ToleLin/E-bick/docs/02_列印.md

# 02 列印

`STL/` 裡的檔案**已經轉成建議的列印方向**（貼床面在 Z=0），丟進 Bambu Studio 不用再轉。
`PRINT/` 是用 Bambu Studio 2.x CLI 切的參考檔（A1、紋理 PEI 板），克數與時間來自它。
用 Bambu Studio 開啟時會被當成未切片的專案，設定面板也可能顯示預設值；請直接匯入 `STL/`，照下表設定後自己切片。

## 通用設定

| 材料 | 噴嘴 | 層高 | 牆 | 上下層 | 填充 |
|---|---|---|---|---|---|
| PETG-CF | **0.6 硬化鋼**（碳纖會磨壞一般噴嘴） | 0.2 | 6 道 | 5 / 5 | gyroid，見下表 |
| PETG HF | 0.6（同上） | 0.2 | 6 道 | 5 / 5 | 100% |
| TPU 95A HF | 0.4 | 0.2 | 3 道 | 預設 | 20% |

PETG-CF 用「Bambu PETG-CF @BBL A1 0.8 nozzle」耗材預設（0.6 噴嘴也適用），機器設定裡噴嘴類型改成硬化鋼。

## 主機（印一套）

| 檔案 | 材料 | 填充 | 支撐 | 重量 | 時間 | 擺放 |
|---|---|---|---|---|---|---|
| `unit/01_housing_front_PETG-CF.stl` | PETG-CF | 25% | 樹狀（樞軸耳板下方） | 338 g | 12.8 h | 燕尾座正面貼床、立著印；45° 燕尾槽免支撐 |
| `unit/02_housing_rear_PETG-CF.stl` | PETG-CF | 25% | 樹狀（少量） | 326 g | 11.5 h | 前接合面貼床、立著印 |
| `unit/03_bay_lid_PETG-CF.stl` | PETG-CF | 40% | 無 | 45 g | 1.5 h | 蓋面朝下 |
| `unit/04_swing_arm_PETG-CF.stl` | PETG-CF | **60%** | 樹狀（馬達座板下方） | 235 g | 8.7 h | 外側面貼床，已斜 25° 才放得進 256 mm 盤 |
| `unit/05_lift_crank_inner_PETG-HF.stl` | PETG HF | 100% | 無 | 4 g | 0.2 h | 平放 |
| `unit/06_lift_crank_outer_PETG-HF.stl` | PETG HF | 100% | 無 | 7 g | 0.4 h | 曲柄片貼床 |
| `unit/08_lift_handle_PETG-HF.stl` | PETG HF | 100% | 無 | 14 g | 0.5 h | 平放 |
| `unit/09_spacer_pivot_x1_PETG-HF.stl` | PETG HF | 100% | 無 | 2 g | 0.4 h | 立著，印 1 個 |
| `unit/09_spacer_eye_top_x2_PETG-HF.stl` | PETG HF | 100% | 無 | 0.4 g | 0.2 h | **印 2 個** |
| `unit/09_spacer_eye_low_x2_PETG-HF.stl` | PETG HF | 100% | 無 | 0.4 g | 0.2 h | **印 2 個** |
| `unit/07_roller_sleeve_TPU95A.stl` | TPU 95A | 20% | 無 | 50 g | 3.3 h | 立著印 |
| `unit/10_estop_kicker_PETG-HF.stl` | PETG HF（紅） | 100% | 無 | 4.8 g | 0.3 h | 緊急停止觸發桿，內側面貼床 |
| `unit/09_spacer_kicker_x1_PETG-HF.stl` | PETG HF | 100% | 無 | 0.2 g | 0.2 h | 觸發桿軸的墊管 |
| `vendor/makita_cc0/makita18v.3mf`＋`battery_terminal.stl` | PETG-CF | 依原作者 | 依原作者（原作者註明要支撐） | — | — | |

主機合計約 **1.03 kg、40 小時**（不含電池座）。

## 緊急停止拉桿（每台車一支）

| 檔案 | 材料 | 填充 | 支撐 | 重量 | 時間 |
|---|---|---|---|---|---|
| `estop_lever/L/estop_lever_upper_bar22p2_L_PETG-CF.stl`（依車把管徑選 22p2／23p8／25p4） | PETG-CF | 60% | 無（切平面貼床） | 9.6 g | 0.7 h |
| `estop_lever/L/estop_lever_lower_L_PETG-CF.stl` | PETG-CF | 60% | 無 | 8.1 g | 0.5 h |
| `estop_lever/L/estop_lever_blade_L_PETG-HF.stl` | PETG HF（紅） | 100% | 無 | 7.4 g | 0.3 h |

`L` 裝車把左半邊，`R` 資料夾是鏡像版。

**強度相關：**
- 擺臂是受力最大的件（樞軸處彎矩約 50 N·m）。60% 填充、6 道牆，牆的方向與受力平面一致。
- 兩個殼體主要受壓，25% 填充就夠。

## 座管座（每台車印一組）

1. 先用 `tools/fit_my_bike.py` 或 README 的車型表，決定**款式**（std／mtb／fold／minivelo）。
2. 量座管直徑（用游標卡尺，或看座管上的刻字，例如 27.2、31.6）。
3. 到 `STL/base/D<管徑>/` 印這三個檔：
   - `base_front_D<管徑>_PETG-CF.stl`（前半）
   - `base_rear_D<管徑>_<款式>_PETG-CF.stl`（後半，帶燕尾）
   - `liner_D<管徑>_TPU95A.stl`（1 mm 內襯）

例：座管 27.2、標準款 → `STL/base/D27p2/` 的 `base_front_D27p2`、`base_rear_D27p2_std`、`liner_D27p2`。

| 檔案 | 材料 | 填充 | 支撐 | 重量 | 時間 |
|---|---|---|---|---|---|
| base_front | PETG-CF | 60% | 無 | 32 g | 1.5 h |
| base_rear（std） | PETG-CF | 60% | 無（minivelo 款可能要少量支撐） | 64 g | 2.5 h |
| liner | TPU 95A | 20% | 無 | 5 g | 0.7 h |

管徑有 25.4、27.2、28.6、30.9、31.6、33.9、34.9。

**其他管徑**：改 `src/params.py` 的 `POST_DIAMETERS`，再執行 `src/export_print.py`。內襯厚 1 mm、夾具內徑＝管徑＋2.3 mm。

## 印完要做的事

- 608 軸承座孔徑設成 22.1 mm。太緊用砂紙修，太鬆用一層膠帶或樂泰 641。
- M3 熱壓銅螺母：用烙鐵壓進電控艙四角與中間的 5 根柱子。
- 燕尾：主機要能順順滑進座管座。卡住的話，用砂紙磨母槽的斜面（每邊預留 0.3 mm）。
