ToleLin/E-bick/docs/04_設計說明.md

# 04 設計說明：為什麼長這樣

這份記錄每個主要決定的理由與計算，方便之後改版或有人分支改作。分析程式在 `analysis/`、`src/check_*.py`、`src/forces.py`。

## 1. 需求

1. 一台主機在不同腳踏車之間快速換裝，不用工具。
2. 照一般自行車規格，能涵蓋大多數車型。
3. 以 3D 列印為主（PETG-CF、PETG HF、TPU 95A HF；Bambu A1，0.6 硬化鋼噴嘴）。
4. 馬達與電子零件在蝦皮、露天、淘寶買得到。
5. 開源。

## 2. 為什麼是「座管座留在車上＋主機燕尾快拆」

- 夾具是摩擦驅動最常出事的地方。Kepler eBoost 用墊片湊管徑，騎幾分鐘就鬆脫撞輪；BoosterPack 夾不乾淨會整組旋轉。
- 每台車留一個依管徑**精準列印**的座管座（加 1 mm TPU 內襯、4×M5），只裝一次，裝好就不再動。
- 主機在每台車上的位置由座管座決定，換車時不用重調。這也是 Rubbee X 與 Piotr F-drive 的做法。
- 燕尾**由下往上**滑入、頂到上止擋：輪胎往上的反力把主機推進止擋，所以快拆銷平常只承受主機自重與顛簸。

## 3. 為什麼不做「越出力壓越緊」的自增壓

擺臂式摩擦驅動有一條判斷規則：從擺臂樞軸往後輪軸畫一條線，滾輪接觸點在這條線**前方**，驅動反力才會把滾輪往輪胎壓（自增壓）。

用 8 種車型的實際幾何掃過一遍（`analysis/contact_mechanics.py`）：
- 樞軸在座管附近時，這條線落在胎頂前方 24–34°。
- 那個位置正好是**後上叉和框煞橋**的位置，74 mm 寬的馬達塞不進去。
- 把樞軸移到別處讓所有車型都自增壓，最佳化結果是樞軸要在立管上緣下方約 12 cm 的後上叉之間，不可行（`fit_with_reach.py` 等）。

所以改走「**接近中性**」：
- 滾輪接觸在胎頂附近，驅動力對正向力的影響 k = dN/dF 只有 −0.5～+0.17。
- 壓胎力全部由**定力氣壓棒**提供。Rubbee X 也是用 200 N 氣壓彈簧。

## 4. 主機剛性固定＋短擺臂，而不是「整台主機當擺臂」

「整台主機繞座管轉」（參考商品的樣子）在幾何上需要約 300 mm 臂長，彈簧離樞軸又近，要上千牛頓的彈簧才夠，不實際。

改成主機剛性固定在座管座上，內部一支 230 mm 擺臂，氣壓棒裝在離樞軸 180 mm 處，槓桿比好。

## 5. 一台主機怎麼適用 20 吋到 29 吋：座管座帶傾角

- 不同車的胎頂位置差很多：
  - 公路車胎頂在座管束下方約 14 cm。
  - 斜上管登山車的胎頂幾乎和座管束同高。
  - 小徑車的五通比後軸高。
- 公路車的主機不能再往下（會撞立管上緣），登山車不能再往上（會撞座墊）。只靠調夾具高度，擺臂角會差到 22°，超出氣壓棒行程。

解法：把「每台車不同」的調整放在**座管座**上。
- 燕尾可以有傾角（std 0°、mtb −10°、fold +10°、minivelo +30° 並後伸 40 mm），再搭配夾具高度 s。
- 最佳化（`analysis/fit_final.py`）的限制條件：
  - 接觸角在胎頂前 −12°～+14°。
  - |k| ≤ 0.5。
  - 樞軸離胎面 ≥ 25 mm，擺臂離胎面 ≥ 15 mm。
  - 樞軸與馬達要在後上叉線的後上方。
- 結果：
  - 樞軸在座管後 110 mm、夾具中心下 80 mm，臂長 230 mm，**8 種車型擺臂工作角都落在 −20° ± 2.5°**。
  - 主機長度約 36 cm，由「胎頂離座管 24–32 cm」決定，無法再短。

## 6. 氣壓棒與過死點抬臂機構

- **氣壓棒規格**：100 mm、行程 30、250 N。因為各車擺臂角一致，工作長度落在 80–96 mm（壓縮 4–20 mm），各車壓力只差 ±5%。
- **抬臂機構**：氣壓棒上端接在偏心半徑 17 mm 的曲柄上。
  - **工作位置**：曲柄過死點 6°，氣壓棒把把手壓在擋塊上，自己鎖住。
  - **扳到另一個死點**：氣壓棒伸到全長，變成拉桿把擺臂拉起，滾輪離胎 18–38 mm。
- **為什麼是兩片獨立曲柄**：在抬起的死點，氣壓棒軸線會穿過曲柄軸心，所以軸心不能有貫穿的軸。
  - 兩片曲柄各用短軸裝在塔的內外牆上，中間只靠曲柄銷相連，Ø15 的氣壓棒本體能從中間穿過。
- **扳桿手力**：從抬起扳回工作位置，最大約 41 N（`src/forces.py`）。

## 7. 受力（`src/forces.py`，250 N 氣壓棒）

| 項目 | 數值 |
|---|---|
| 正向力 N | 216–237 N（8 車型） |
| 乾地可傳推力（μ 0.6） | 110–152 N |
| 濕地可傳推力（μ 0.3） | 62–72 N |
| 需求：25 km/h 巡航 250 W | 36 N |
| 需求：6% 坡 12 km/h | 58 N |

μ 是設計假設：滾輪對輪胎沒有可靠的量測資料，研究報告用乾 0.6、濕 0.3。

**建議第一個實驗**：印幾個 TPU 滾輪套，用彈簧秤實測乾、濕兩種狀態的 μ。

## 8. 馬達、滾輪、電壓

詳見 [01 零件與採購](01_零件與採購.md) 第 1 節與 [研究報告](research/motor.md)。

- 外殼當滾輪（A 架構）：零件最少，軸承負載落在馬達兩顆內部軸承之間，壽命夠（估計 L10 約 3,700 h）。
- 研究也比較了「小滾輪＋10S 36V＋外側軸承」（B 架構），它銅損較低。但 Ø35 小滾輪的壓胎損失與磨胎較大，而且需要 36V 電池，失去牧田電池隨插即用的方便。
- **v0.1 選 A 架構＋牧田 18V。**

## 9. 列印方向決定的幾何細節

- 燕尾從 60° 改成 **45°**：主機前段立著印時，燕尾槽斜面是 45° 懸空，免支撐。
- 主機後段接合面貼床立著印，車尾不加擋板（45° 斜裙會撞到抬起的馬達）。
- 擺臂外側面拉平到同一平面，平放貼床；斜放 25° 才放得進 A1 的 256 mm 盤。
- STL 用 build123d 直接網格化（公差 0.02 mm）。cadgen 內建網格精度是零件尺寸的 0.25%，會讓 608 軸承孔誤差 0.4 mm。

## 10. 控制

- 只做踏頻助力，不做油門（法規、安全）。
- 標準藍牙 CSC 踏頻感測器綁在曲柄，ESP32-C3 收踏頻，用 UART 送 `setCurrent` 給 VESC。
- 車速用滾輪轉速算：摩擦驅動時滾輪表面速度＝胎面速度＝車速，和輪徑無關。
- 停踩判定：最後一圈曲柄事件後 1.2 秒。感測器約每秒通知一次，總延遲約 1–2.5 秒，符合檢測基準「3 秒內停止」。
- 已知限制：
  - 踏頻感測器分不出倒踩（檢測基準要求倒踩不出力）。
  - 沒有煞車斷電開關（要接線，違反免接線的設計）。
- 為什麼不用 VESC 內建 PAS：它只吃雙霍爾有線 PAS，而且預設佔用 UART 腳位。

## 10.5 緊急停止拉桿（v0.2）

詳見 [05 緊急停止拉桿](05_緊急停止拉桿.md)。設計重點：

- **純機械，直接把滾輪抬離輪胎**。不管電子有沒有故障，推進都會中斷；依需求這版不做電子斷電。
- **借用現成的過死點抬臂機構**：工作位置只過死點 6°，鎖緊力矩 0.53–0.58 N·m，所以只要把它往回推過死點，氣壓棒自己會完成抬起，而且停住後不會自己回去（自鎖）。
- **觸發桿要把把手頂到過死點 16°**：曲柄軸是塑膠孔配螺絲，摩擦估計 0.5 N·m，剛過死點時氣壓棒的推力矩只有 0.02 N·m 推不動。
  - 過死點 16° 時推力矩約 1.2 N·m，是摩擦的兩倍以上。
  - 觸發桿幾何用 `analysis/estop_kicker.py` 搜尋：轉 32.4°、拉線 12.7 mm、張力約 47 N。
- **觸發桿只推不拉**：把手被頂開後可以自由轉到抬起位置；恢復時把手往下壓，會順便把觸發桿與拉線推回原位。
- **車把拉桿的配置**：和一般煞車把相同（拉桿片朝外、線頭在樞軸前方、線管往內出去），但：
  - 夾在龍頭附近的空車把上，拉桿片只有 52 mm，避開現有變速把、煞車把。
  - v0.3 精簡：樞軸移到車把正前方、線頭臂 20 mm，座子 45 × 64 × 47 mm（v0.2 是 56 × 74 × 50），三件 25 g；列印件之間會動的地方每邊留 1 mm（使用者的列印誤差約 0.2 cm）。
  - 拉桿平面在車把下方，拉的時候從車把下面掃過。
  - 座子拆成上下兩件，都能免支撐列印。
- **每台車一支拉桿與線**，主機端的線管座是「內線從側槽放進去、線管頭從前方推入」（不靠卡扣），線頭從側面放進觸發桿，換車時 5 秒接上。

## 11. 已知限制與下一版

**未實測**：

| 項目 | 驗證方式 |
|---|---|
| 滾輪 μ | 實測 |
| TPU 滾輪套耐磨性 | 騎乘測試 |
| 氣壓棒實際尺寸／力量 | 到貨確認 |
| 列印件長期潛變 | PETG-CF 在夏天曝曬的溫度下 |
| 牧田電池座端子能承受的電流 | 實測 |

**下一版可以做**：
- 曲柄上加陀螺儀，在 0.3 秒內偵測停踩與倒踩（研究報告第二階段）。
- 把手加藍牙段位按鈕。
- 減重：殼體鏤空、樞軸耳板改桁架。目前主機列印件約 1.0 kg。
- 碳纖座管專用的寬夾具。
- 36V（兩顆牧田串聯）版本。

## 12. 參考與致謝

- MikeKaiser/eBike_v1（MIT）：參數化座管夾、擺臂 45° 規則
- JK_Prints Universal Friction Drive（CC BY-SA）：PETG 0.6 噴嘴厚牆參數
- Piotr Strzałka F-drive：每台車留底座的換裝架構
- Kepler 摩擦驅動（Endless-Sphere）：密封軸承樞軸、限位、VESC FOC 經驗
- Rubbee X：200 N 氣壓彈簧
- fablab.ee、axel：CC0 牧田電池座與端子
- 完整調查報告與查證：`docs/research/`
