ToleLin/E-bick/docs/01_零件與採購.md

# 01 零件與採購

價格是 2026-11-07 查到的參考值。
- 露天的標價是用露天 API 實際抓到的。
- 蝦皮、淘寶的商品頁搜尋引擎抓不到，只列搜尋關鍵字；標「估」的是沒有查證的估計值。

露天幾個主力賣場是代購、**成交數 0**，下單前請看賣家評價或問清楚出貨地。

## 1. 馬達：6374 外轉子無刷馬達（170KV、有感）

### 為什麼選它

PostRoller 用馬達外殼直接當滾輪（外面套 3 mm TPU，Ø69 mm）。

**扭力與銅損：**
- 6374 的馬達常數最大（Km ≈ 0.23 N·m/√W），同樣推力下銅損最小。6354 約多一倍，5065 約多兩倍半。
- 6% 爬坡（推力 58 N，滾輪扭力 2.0 N·m）時，6374 銅損約 77 W，6354 會到 150 W。

**選 170KV 而不是 140KV，原因有二：**
- 牧田 18V 電池快沒電（15 V）時，170KV 的 80% 空載轉速仍有 26 km/h，140KV 只剩 22 km/h。
- 下坡時滾輪被輪胎帶著轉，反電動勢會超過電池電壓並回灌電池。170KV 要到約 48 km/h 才發生，140KV 約 40 km/h 就會。

### 規格

依 Flipsky 官方圖面，副廠 6374 尺寸可能不同，**到貨請實量**。

| 項目 | 數值 |
|---|---|
| 外形 | 外殼 Ø63 × 74 mm，含軸總長 108 mm |
| 安裝孔 | **4×M4、深 5 mm、孔位圓 PCD Ø44**（擺臂的馬達座開長孔，PCD 30–46 都能鎖） |
| 軸 | Ø8 mm 圓軸附鍵槽（鍵寬 3、長 20），從**安裝面那側**伸出 34 mm（根部 Ø10 台階） |
| 出線 | 三相線＋6 pin 霍爾線，從安裝面附近的凸座徑向出線（凸座朝擺臂方向裝） |
| 極數 | 14 極（7 對極） |
| 電壓／電流 | 3–12S；最大 85 A、3500 W、8 N·m（本設計只用到約 28–35 A） |
| 扭力常數 | 170KV：Kt ≈ 0.056 N·m/A；140KV：Kt 0.067 N·m/A、相電阻 0.044 Ω |
| 重量 | 約 0.98 kg |

在本設計裡的工作點（Ø69 滾輪）：

| 情況 | 推力 | 滾輪扭力 | 相電流（170KV） | 電池電流（18 V） |
|---|---|---|---|---|
| 平路 25 km/h，約 250 W | 36 N | 1.24 N·m | 約 22 A | 約 15 A |
| 6% 坡 12 km/h | 58 N | 2.0 N·m | 約 36 A | 約 13 A |

### 哪裡買

| 管道 | 商品／關鍵字 | 價格 |
|---|---|---|
| 露天 | 「【台灣現貨】板車外轉子無刷大電機馬達 N5065 6354 N6364 C6374…」規格選 **6374-170KV 有感** https://www.ruten.com.tw/item/show?22543223395022 | NT$2,228 |
| 露天 | 「【可開統編】6374 170KV無刷馬達滑板車馬達…」有感 https://www.ruten.com.tw/item/show?22632318875322 | NT$2,220 |
| Flipsky 官網 | 6374 140/170/190KV（Battle Hardened） | US$87（約 NT$2,860，未含運費關稅） |
| 蝦皮／露天關鍵字 | `6374 170KV 有感`、`6374 無刷 外轉子 有感` | |
| 淘寶關鍵字 | `6374 外转子无刷电机 有感 170KV`、`翻天 Flipsky 6374` | 約 ¥140–210（估） |

**要買「有感」（帶霍爾線）的版本。**
- 摩擦驅動在車子動起來後馬達本來就在轉，無感也能用。
- 但有感版低速、坡道起步比較穩，也比較安靜。

## 2. 電控：VESC（Makerbase MKSESC MINI V6.7）

| 項目 | 數值 |
|---|---|
| 電壓 | 8–60 V（3–12S），牧田 5S 在範圍內 |
| 電流 | 連續 50 A、峰值 150 A |
| 尺寸 | 67 × 39 × 20 mm（電控艙內用束帶固定） |
| 介面 | USB、CAN、UART（接 ESP32）、霍爾 |
| 價格 | 露天 NT$2,309 https://www.ruten.com.tw/item/show?22641852738525 （成交 0）；NT$2,430 https://www.ruten.com.tw/item/show?22521646076876 |
| 關鍵字 | `Makerbase VESC MINI V6.7`、`班傑明電調 VESC 6.7`、淘寶 `Makerbase VESC MINI 6.7 本杰明电调` |

可替代：Flipsky Mini FSESC 6.7 PRO 70A（4–12S，尺寸相同，官網 US$57）。

**不建議用便宜的航模電變或電動車控制器：**
- 摩擦驅動起步負載大，航模電變搭大馬達會失步尖叫。
- 36V 電動車控制器跑不了這種高轉速外轉子馬達（沒有查證）。

## 3. 電池：牧田 18V（5S）

| 項目 | 說明 |
|---|---|
| 電池 | 牧田 BL1850B（5Ah、約 90 Wh、約 630 g）或 BL1860B（6Ah）。原廠約 NT$3,500–4,300；副廠便宜但保護電路品質不一 |
| 續航 | 摩擦驅動實測約 5–8 Wh/km（輔助騎乘）→ 5Ah 約 10–15 km、6Ah 約 11–18 km |
| 電池座 | 印 `vendor/makita_cc0/makita18v.3mf`（fablab.ee，CC0），端子用 `battery_terminal.stl`（axel，CC0）＋6.3 mm 公插片；鎖在主機右側牆的 4 個 M5 孔 |
| 現成座（替代） | 蝦皮「大藝牧田電池轉XT60/DC輸出底座」NT$238–258（外形不同，要自己改孔位） |
| 注意 | 牧田電池的過放／過熱保護可能要靠工具端讀信號腳才會作動。只接正負極時，**一定要在 VESC 設低電壓斷電**（見 03） |

## 4. 控制：藍牙踏頻感測器＋ESP32-C3

| 零件 | 說明 | 價格 |
|---|---|---|
| 踏頻感測器 | Magene 邁金 S3+（藍牙＋ANT+，CR2032）。用橡皮圈綁曲柄；裝電池的方式決定「速度／踏頻」模式，要設成**踏頻**。其他標準藍牙 CSC 踏頻器也可以 | 蝦皮 NT$450–550 |
| ESP32-C3 SuperMini | 跑 `firmware/`，用 UART 命令 VESC | 蝦皮 NT$38–100（關鍵字 `ESP32-C3 SuperMini`） |
| 12 mm 按鍵（常開、瞬時） | 段位切換，裝電控艙右側 | 約 NT$30（估） |
| 5 mm LED＋330 Ω | 段位指示 | 約 NT$5 |
| 16 mm 自鎖開關 | 切 ESP32 的 5 V＝助力總開關 | 約 NT$40（估） |

## 5. 機構件

| 零件 | 規格 | 數量 | 關鍵字／備註 |
|---|---|---|---|
| 氣壓棒 | **眼到眼 100 mm、行程 30 mm、250 N**，兩端 Ø8 眼（或 M8 牙＋眼端頭）。乾燥地區、高壓公路胎可用 200 N，常下雨用 300 N | 1 | 蝦皮 `氣壓棒 100mm 行程30 250N`、淘寶 `气弹簧 100mm 行程30 250N`（**規格與價格未查證**，約 NT$150–300） |
| 608 軸承 | 8×22×7，建議 608-2RS（雙面膠封，防水） | 3 | 樞軸 2、馬達軸端 1 |
| 球鎖快拆銷 | Ø6 × 有效長 60 mm，附拉環／繩 | 1 | `球頭快拆銷 6mm 60`、淘寶 `球头快拆销 6*60`（未查證） |
| M8 螺絲 | 樞軸 M8×70＋防鬆螺帽＋墊圈 2；氣壓棒下眼 M8×45＋防鬆螺帽；上眼 M8×35＋防鬆螺帽；內曲柄短軸 M8×16；把手 M8×16；M8 螺帽 2 顆（埋進內、外曲柄） | 各 1 | |
| M5 螺絲 | 座管座 M5×20＋螺帽 ×4（每台車）；主機前後段 M5×16＋螺帽 ×4；電池座 M5×12＋螺帽 ×4 | | |
| M4 螺絲 | M4×10（馬達固定，**馬達螺孔只有 5 mm 深，不要用更長的**） | 4 | |
| M3 | M3 熱壓銅螺母 ×5＋M3×8 ×5（電控艙蓋） | | |
| 魔鬼氈束帶 | 25 mm 寬，從座管座前方扣環綁到座墊弓，防止整組繞座管轉 | 每台車 1 | |

## 6. 電線與接頭

| 零件 | 說明 |
|---|---|
| XT60 公母各 1 | 電池座 → VESC（XT30 只能持續 15 A，不夠） |
| 12 AWG 矽膠線 | 約 0.5 m 紅黑 |
| 30 A 汽車插片保險絲＋防水座 | 電池正極出口 |
| 馬達延長線 | 6374 的三相線與霍爾線長度要到電控艙（擺臂內側走線，約 25 cm），不夠就用 3.5/4 mm 香蕉頭延長＋霍爾延長線 |

## 6.5 緊急停止拉桿（v0.2，機械式）

詳見 [05 緊急停止拉桿](05_緊急停止拉桿.md)。每台車要一支車把拉桿與一條煞車線；主機端只多一個觸發桿。

| 零件 | 數量 | 關鍵字／備註 |
|---|---|---|
| MTB 煞車內線（Ø1.5，圓柱線頭） | 每台車 1 | 蝦皮 `剎車線 內線 登山車`，約 NT$30–60 |
| 5 mm 煞車線管＋線管頭 | 每台車約 1.5 m＋2 個 | `剎車線管 5mm`，約 NT$50–100 |
| 免焊螺絲線頭 | 每台車 1 | `剎車線頭 免焊` / 淘寶 `刹车线头 螺丝固定`（未查證），約 NT$20 |
| M4×20＋防鬆螺帽 2 組、M4×16＋螺帽 1 組 | 每支拉桿 | 拉桿樞軸、上下件接合、夾具鎖緊 |
| M4 熱壓銅螺母＋M4×14＋墊圈 | 主機 1 組 | 觸發桿的軸 |

## 7. 材料

| 線材 | 用量 | 用在 |
|---|---|---|
| PETG-CF（Bambu PETG-CF） | 約 1.0 kg | 主機殼、擺臂、艙蓋、座管座（需**硬化鋼噴嘴**） |
| PETG HF | 約 30 g | 抬臂桿、曲柄、墊片 |
| TPU 95A HF | 約 55 g＋每台車 5 g | 滾輪套、座管內襯 |

## 8. 成本估計（不含電池、充電器、工具）

| 項目 | 約 NT$ |
|---|---|
| 6374 170KV 有感 | 2,200 |
| VESC MINI V6.7 | 2,300–2,450 |
| 踏頻感測器＋ESP32＋按鍵開關 | 650 |
| 氣壓棒、軸承、快拆銷、螺絲 | 600（估） |
| 電線、接頭、保險絲、電池座端子 | 350（估） |
| 緊急停止拉桿（每台車：煞車線、線管、螺絲） | 150（估） |
| 線材 | 1,200（估） |
| **合計** | **約 7,450–7,950** |

對照：你截圖的 eBay 18V 摩擦驅動套件 US$339（約 NT$11,137）；市售呂布雲輪摩擦輪＋控制器 NT$7,365，整套含電池 NT$17,606 起。
