ToleLin/E-bick/docs/research/regulation.md

# 研究報告：regulation

# 台灣法規與安全限制：DIY 外掛式摩擦驅動電動助力（查證日 2026-11-07）

**一句話結論：** 依現行條文，DIY 自製、沒有通過型式審驗的外掛助力單元，**不能合法騎上公眾通行的道路**。可能被套用的條文有好幾條，最重的是把整台車「依汽車之拼裝車輛處理」，罰鍰新臺幣 3,600～36,000 元，車子會被當場移置保管，條文也有沒入規定。

**法規層級說明：**
- 法律是「道路交通管理處罰條例」（以下稱處罰條例）。
- 命令是「道路交通安全規則」（以下稱道安規則）、「電動輔助自行車及微型電動二輪車型式安全審驗管理辦法」（以下稱審驗辦法），以及「電動輔助自行車安全檢測基準」（以下稱檢測基準）。
- 下面寫的都是條文內容加出處，不是法律意見。

---

## 1. 定義：電動輔助自行車與微型電動二輪車

| 項目 | 電動輔助自行車（電輔車） | 微型電動二輪車（微電車，2022 年前叫「電動自行車」） | 出處 |
|---|---|---|---|
| 法律定義 | 經型式審驗合格、**以人力為主、電力為輔**、最大行駛速率 25 km/h 以下、車重 40 kg 以下的二輪車 | 經型式審驗合格、**以電力為主**、25 km/h 以下、不含電池 40 kg 以下或含電池 60 kg 以下 | [處罰條例§69](https://law.moj.gov.tw/LawClass/LawSingle.aspx?pcode=K0040012&flno=69) |
| 上路前提 | 檢測及型式審驗合格，並「黏貼審驗合格標章」（貼在下管明顯處） | 檢測及型式審驗合格，並登記、領用、懸掛牌照 | [§69-1](https://law.moj.gov.tw/LawClass/LawSingle.aspx?pcode=K0040012&flno=69-1)、[審驗辦法§3、§11](https://law.moj.gov.tw/LawClass/LawAll.aspx?pcode=K0040068) |
| 誰能申請審驗 | 國內完成車由合格製造廠申請，進口完成車由代理商或進口人申請。**辦法沒有讓個人替自己改裝的車申請的管道**，也沒有改裝套件的審驗類別 | 同左 | [審驗辦法§5、§9](https://law.moj.gov.tw/LawClass/LawAll.aspx?pcode=K0040068) |
| 強制險 | 條文沒有要求 | 必須投保強制汽車責任保險，沒保就不受理登記或發照 | [§69-1](https://law.moj.gov.tw/LawClass/LawSingle.aspx?pcode=K0040012&flno=69-1) |
| 安全帽 | 處罰條例沒有罰則（§73 的安全帽罰則只寫微電車） | 必須戴，未戴罰 NT$300（§73，修正條文 2026-10-31 施行） | [§73](https://law.moj.gov.tw/LawClass/LawSingle.aspx?pcode=K0040012&flno=73) |
| 年齡 | §72-2 沒有列電輔車 | 未滿 14 歲騎乘罰 600～1,200 元，車輛移置保管 | [§72-2](https://law.moj.gov.tw/LawClass/LawAll.aspx?pcode=K0040012) |
| 掛牌時程 | 不掛牌 | 2022-05-04 公布修正、2022-11-30 施行；舊車兩年緩衝，113-11-30（2024-11-30）前要完成掛牌 | [車安中心專文](http://vsccdms.vscc.org.tw/webfile/Epaper/500000285/File/9ad97bb2-0636-4017-9dc8-5ef300c696cc.pdf)、[交通部168](https://168.motc.gov.tw/theme/ebike)、[中央社 2024-11-30](https://www.cna.com.tw/news/asoc/202411300065.aspx) |

**電輔車的技術門檻**（[檢測基準修正規定，行政院公報 2022-11-29](https://gazette.nat.gov.tw/EG_FileManager/eguploadpub/eg028227/ch06/type2/gov50/num23/images/Eg01.pdf)，2024-01-01 起各型式都適用）：
- **重量：** 車輛空重含電池 ≤ 40 kg，不得裝側方腳踏板。
- **電壓：** 鋰電池最高工作電壓 < 60 V。18 V 是 5 串，滿電 21.0 V，在限制內。
- **馬達功率：** 最大輸出 < 400 W，或最大連續額定 ≤ 250 W。
- **停踩斷電：** 停止踩踏 3 秒內停止出力；或有煞車斷電開關者 5 公尺內、沒有者 2 公尺內停止輔助。倒踩時馬達不得驅動。
- **超速斷電：** 超過 25 km/h 時，要在 25 km/h +10% 範圍內自動斷電，且要有防止擅改速限的設計。
- **故障斷電：** 煞車訊號線或超速訊號線短路、斷路時，3 秒內斷電。
- **防竄改：** 不得以外部行為、改軟體或韌體變更速限，電子控制裝置要有防擅改封印。
- **油門：** 唯一允許不踩就出力的是「起動輔助模式」，最高 6 km/h，而且必須靠騎乘者持續操作才會作動。所以**純油門、不踩也能走的設計，在法律上會被歸到「以電力為主」的微電車**，要審驗、掛牌、保險。
- **微電車的技術門檻：** 搜尋摘要看到臺北市法規文件寫「電動機最大輸出功率小於 1 kW、鋰電池最高工作電壓小於 60 V」（[來源](https://www.laws.taipei.gov.tw/lawatt/Law/A040110051045100-20221128-1000-005.pdf)）。**這點是 UNVERIFIED，原文沒有逐字核對。**

---

## 2. 自製、未審驗的外掛單元能不能上公眾道路？

**相關條文：**
- [道安規則§119](https://law.moj.gov.tw/LawClass/LawSingle.aspx?pcode=K0040013&flno=119) 第 4 項原文：「慢車擅自加裝補助引擎或馬達行駛者，依汽車之拼裝車輛處理。」同條第 1 項規定慢車不得擅自變更裝置。
- [審驗辦法](https://law.moj.gov.tw/LawClass/LawAll.aspx?pcode=K0040068)沒有個人或改裝套件的審驗途徑，所以「每台腳踏車快速換裝」的單元在制度上**無法取得**審驗合格標章或牌照。

**可能適用的罰則**（實際用哪一條由警察或監理機關認定，我無法替你判斷）：

| 情境 | 條文 | 處罰 |
|---|---|---|
| 一般腳踏車加裝馬達，被依道安規則 §119 第 4 項當成拼裝車 | [處罰條例§12 第1項第2款](https://law.moj.gov.tw/LawClass/LawSingle.aspx?pcode=K0040012&flno=12) | 罰所有人 3,600～36,000 元，當場移置保管；第 2 項明文第 2 款的車輛「並沒入之」。新罰額 2025-09-30 施行（[工商時報](https://www.ctee.com.tw/news/20250930700616-431401)、[NOWnews](https://www.nownews.com/news/6706656)） |
| 被認定為未經型式審驗的電輔車 | [§71 第2項](https://law.moj.gov.tw/LawClass/LawSingle.aspx?pcode=K0040012&flno=71) | 「未經型式審驗合格之電動輔助自行車，於道路行駛者，沒入之。」 |
| 有油門、以電力為主，被認定為未審驗、未掛牌的微電車 | [§71-1](https://law.moj.gov.tw/LawClass/LawSingle.aspx?pcode=K0040012&flno=71-1) | 罰 1,200～3,600 元並禁止行駛；未經型式審驗合格的「沒入之」 |
| 改變電輔車或微電車的電子控制裝置或原有規格 | [§72 第2項](https://law.moj.gov.tw/LawClass/LawSingle.aspx?pcode=K0040012&flno=72) | 3,600～7,200 元，禁止行駛，責令改正 |
| 一般慢車擅自變更裝置 | §72 第1項 | 300～1,200 元，限期改正 |
| 交通部舊函釋：電輔車超過 25 km/h | [交通部 110-08-24 函](https://www.mvdis.gov.tw/webMvdisLaw/SorderContent.aspx?SOID=16138)，指向 [§32-1](https://law.moj.gov.tw/LawClass/LawSingle.aspx?pcode=K0040012&flno=32-1) | 1,200～3,600 元並禁止行駛。這是 2022 年修法前的函釋，部分可能已被新條文取代 |

**執法實例：** 2022 年台南警方沒入 63 輛拼裝微電車、40 個改裝電控（[中央社](https://www.cna.com.tw/news/aloc/202208120053.aspx)）。我沒有找到專門取締「腳踏車外掛摩擦驅動」的新聞或函釋，這部分是 UNVERIFIED。

**私人土地與測試：**
- [§3](https://law.moj.gov.tw/LawClass/LawSingle.aspx?pcode=K0040012&flno=3) 規定「道路」是「公路、街道、巷衖、廣場、騎樓、走廊或其他供公眾通行之地方」。照字面，不供公眾通行的私人封閉場地不在範圍內。
- 但騎樓、廣場、開放通行的私人巷道、河濱自行車道都可能算道路。
- 我沒有找到個人上路測試的豁免條文。審驗辦法 §9 第 3 項的「自行使用、每年不超過三輛」只適用於進口完成車。

**事故責任：**
- 未審驗的車沒有強制險。
- [民法§191-2](https://law.moj.gov.tw/LawClass/LawSingle.aspx?pcode=B0000001&flno=191-2) 規定「非依軌道行駛之動力車輛」的駕駛人要負推定過失的賠償責任。加了馬達的車是否落入這條，要看個案認定（UNVERIFIED）。

---

## 3. 鋰電池：BSMI 規定與 DIY 安全

**BSMI 規定**（[標檢局「應施檢驗3C二次鋰行動電源等五項商品」規定](https://law.moea.gov.tw/Download.ashx?FileID=190822&id=GL000592&type=LAW)）：
- **電輔車電池：** 「電動輔助自行車用二次鋰電池/組」是應施檢驗商品。檢驗標準 CNS 15387（104年版）、CNS 15424-1、CNS 15424-2（104年版）。檢驗方式為型式認可逐批檢驗或驗證登錄（模式2加3），2019-01-01 起實施邊境管制（輸入規定代號 C02）。「電動自行車用」也列在同一份規定裡。
- **充電器：** 標檢局文件也有列電動輔助自行車用非車載型充電器（[花蓮分局 PDF](https://hualien.bsmi.gov.tw/wSite/public/Data/f1536119976910.pdf)）。這份是掃描檔，我沒能讀到細節，UNVERIFIED。
- **審驗時的用途：** 檢測基準 4.2 允許用標檢局的二次鋰電池組驗證登錄證書代替電池文件（[公報](https://gazette.nat.gov.tw/EG_FileManager/eguploadpub/eg028227/ch06/type2/gov50/num23/images/Eg01.pdf)）。
- **商品檢驗法的範圍**（[全文](https://law.moj.gov.tw/LawClass/LawAll.aspx?pcode=J0100001)）：
  - §6：不合格的應施檢驗商品「不得運出廠場或輸出入」，銷售者也不得陳列或銷售。
  - §9：非銷售的自用品、研發測試用物品進口可以免驗。
  - §60：違規運出廠場、輸入或上市，罰 20 萬～200 萬元。
  - **意思是：** 自己做、自己用，不屬於「上市商品」。但只要開源專案**販售電池或套件**，就要先取得驗證。
- **自用品進口：** 自用品單一項次 ≤ 美金 1,000 元可以直接通關（[標檢局 FAQ](https://www.bsmi.gov.tw/wSite/public/Attachment/f1697612609312.pdf)）。這是搜尋摘要所見，UNVERIFIED。
- **不適用的新規定：** 2027-07-01 起施行的「道路車輛動力用二次鋰電池組」規定只管四輪以上車輛（[台南分局](https://tainan.bsmi.gov.tw/wSite/public/Data/f1766539217438.pdf)，搜尋摘要所見）。
- **集運：** 淘寶集運能不能寄裸電芯（例如 18650）**UNVERIFIED**，要直接問集運業者。

**DIY 電池安全實務：**
- **優先買現成的：** 盡量買有 BSMI 標示的成品電池組。美國 CPSC 建議不要用「非合格人員改造的電池組」或「再利用、二手電芯」（[CPSC 2025-09-04](https://www.cpsc.gov/node/65775)）。
- **BMS：** 一定要有，含過充、過放、過流、短路保護，最好加溫度感測。BMS 規格要配合 5 串 Li-ion（4.2 V/串），電流額定要大於控制器峰值。社群指南認為即使只有一、兩顆電芯也要有 BMS（[Hackaday](https://hackaday.com/2019/06/12/an-exhaustive-guide-to-building-18650-packs)）。
- **保險絲：** 電池正極出口一定要裝主保險絲。額定值低於線材容許電流（工程慣例）。
- **組裝：** 用點焊純鎳片，不要直接焊錫在電芯上；並聯多顆時考慮單顆保險絲線。這些是社群和廠商的建議（[Hackaday](https://hackaday.com/2019/06/12/an-exhaustive-guide-to-building-18650-packs)），可信度屬中等。
- **電芯：** 使用全新、同型號、同批次的電芯。
- **充電器：** 只用原廠或匹配的 CC/CV 21.0 V 專用充電器，CPSC 警告不要用萬用充電器（[CPSC 2024](https://www.cpsc.gov/zh-CN/Newsroom/News-Releases/2024/CPSC-Urges-Consumers-to-Not-Buy-or-Use-Universal-Chargers-with-Micromobility-Products-Due-to-Fire-Hazard)）。
- **充電習慣：** 充電時人要在場、不要睡覺時充（CPSC）。不要在日曬、雨淋或潮濕處充電，不要過充，電池膨脹或異常發熱就立刻停用（新北消防，[公視](https://news.pts.org.tw/article/618242)，搜尋摘要所見）。0°C 以下不得充電，充電溫度範圍 0～45°C（[Battery University BU-410](https://batteryuniversity.com/article/bu-410-charging-at-high-and-low-temperatures)）。
- **列印外殼：** 不要把 PETG-CF 外殼當成電氣絕緣（碳纖維填充材的導電性依配方不同，UNVERIFIED），電芯要另外用青殼紙或熱縮膜絕緣。電池艙要獨立、固定好、避免振動磨損。這兩點是工程建議，不是法規。

---

## 4. 你該知道的事

1. 台灣只有兩種合法的電動自行車：**電輔車**（貼審驗標章）和**微電車**（掛牌加強制險），都必須是業者送審的「完成車」。條文裡沒有讓個人替外掛套件申請審驗的途徑。
2. 道安規則 §119 明文：腳踏車擅自加裝馬達行駛，依汽車的拼裝車輛處理。罰 3,600～36,000 元、當場移置保管，條文還有沒入。另外 §71、§71-1 也有未審驗車輛沒入的規定。
3. 設計上做到 25 km/h 斷電、踩踏感測、≤250 W 連續功率、不加油門，**仍然不會變成合法車**，因為還是沒有審驗合格標章。不過這樣做最接近電輔車的技術規格，也比較安全，值得當作開源設計的預設值。
4. 有油門、不踩也能走的設計，法律上屬於「以電力為主」的微電車，要件更多：審驗、掛牌、保險、戴安全帽、年滿 14 歲。
5. 條文上的「道路」包含騎樓、廣場、巷弄、自行車道等任何供公眾通行的地方。私人封閉場地不算，但我沒有找到測試豁免。
6. 未審驗的車沒有強制險，發生事故要自己承擔民事賠償，可能適用民法 §191-2 的動力車輛推定過失。
7. 自己組 18 V（5 串）電池：電壓遠低於 60 V 的上限，但 BMS、主保險絲、專用充電器、有人在場充電都不能省。CPSC 不建議使用二手或拆機電芯。
8. 開源專案只放設計檔，跟「販售」不同。只要開始賣電池或套件，電池（可能還有充電器）就要先取得 BSMI 驗證，否則依商品檢驗法 §60 可罰 20 萬～200 萬元。
9. 這份整理不能取代主管機關的意見。如果要確定外掛套件在你這個情況會被怎麼處理，可以向交通部公路局或當地警察局、車安中心（VSCC）書面詢問。
