ToleLin/E-bick/docs/img/base_std.png

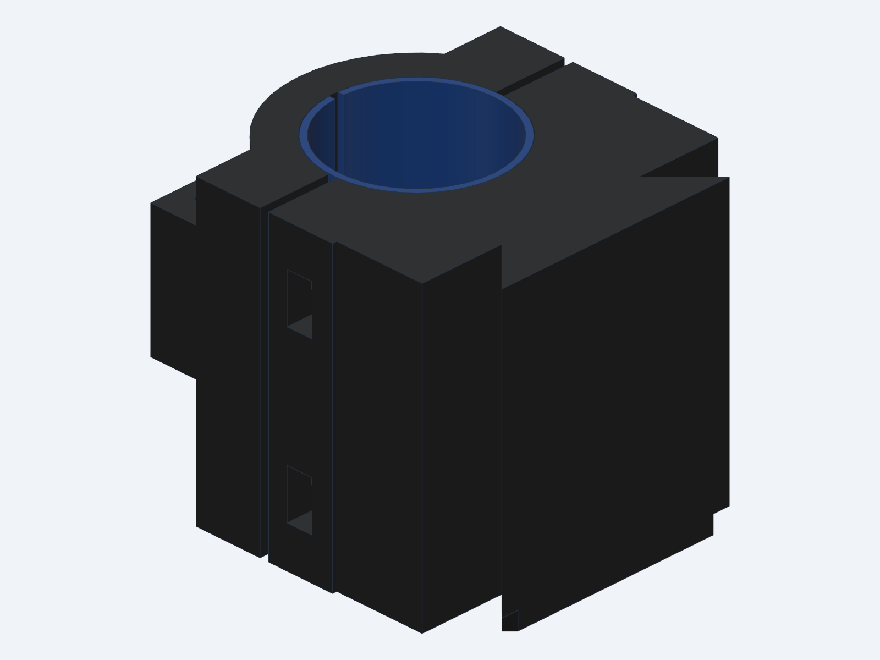
docs/img/base_std.png
