ToleLin/E-bick/docs/img/on_minivelo_left.png

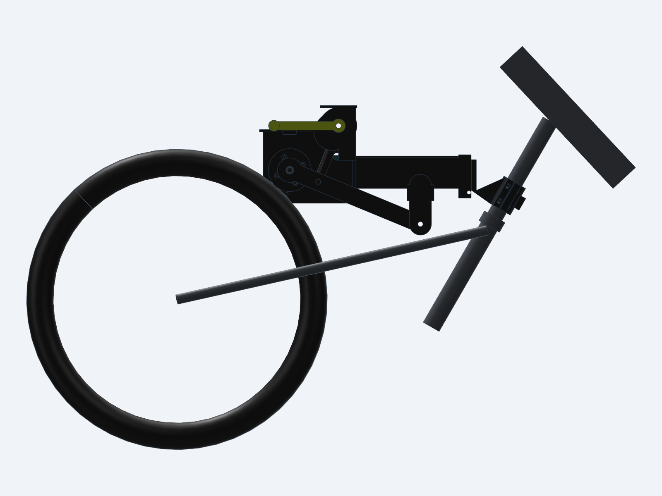
docs/img/on_minivelo_left.png
