ToleLin/E-bick/docs/img/on_mtb29_left.png

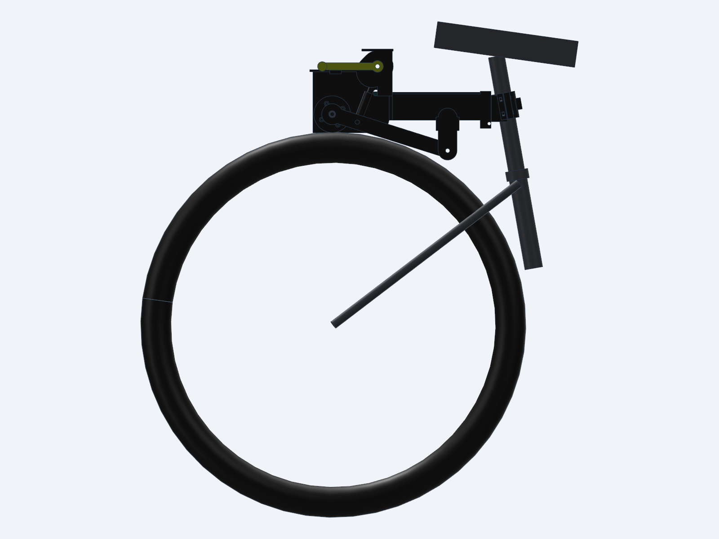
docs/img/on_mtb29_left.png
