ToleLin/E-bick/docs/img/on_road_left.png

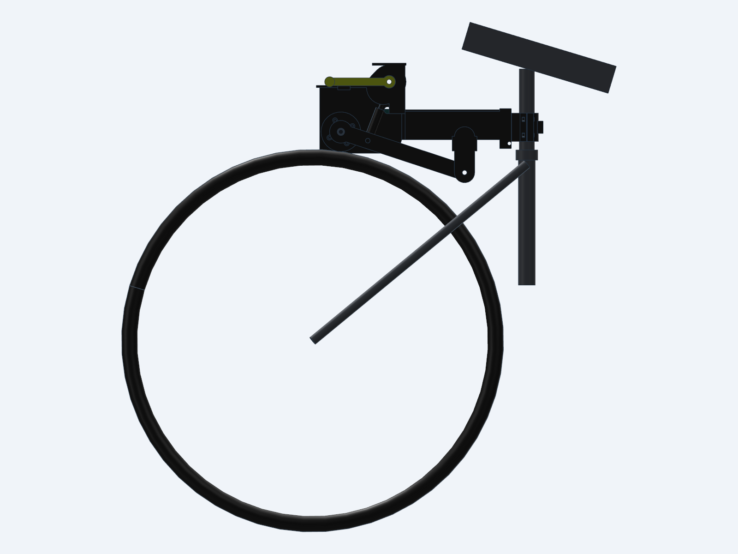
docs/img/on_road_left.png
