ToleLin/E-bick/docs/img/unit_iso.png

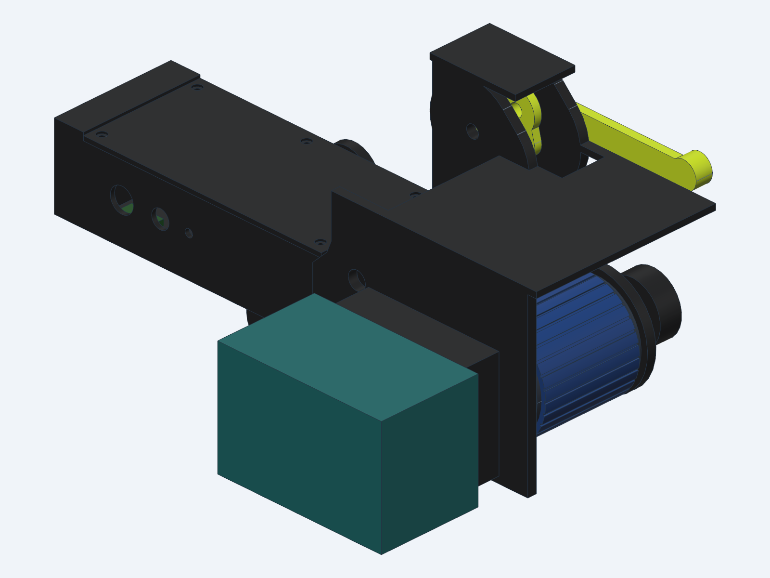
docs/img/unit_iso.png
