ToleLin/E-bick/docs/img/unit_left_lifted.png

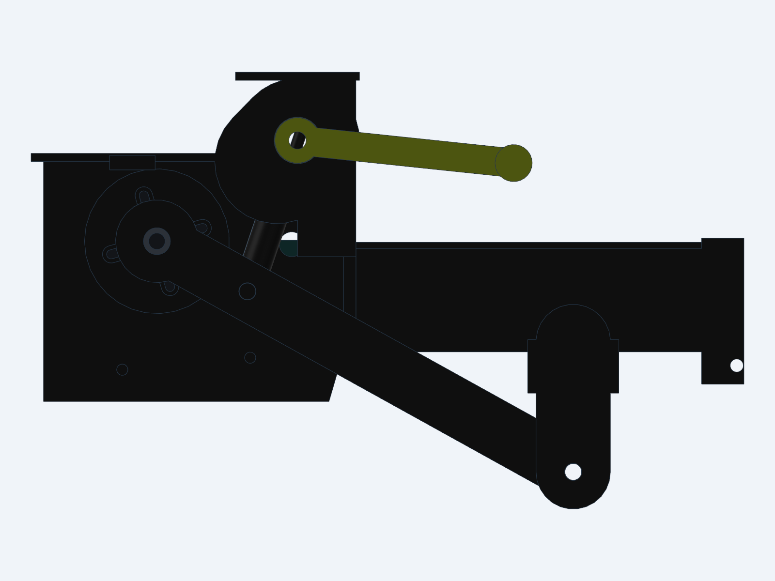
docs/img/unit_left_lifted.png
