ToleLin/E-bick/STEP/postroller_unit.step

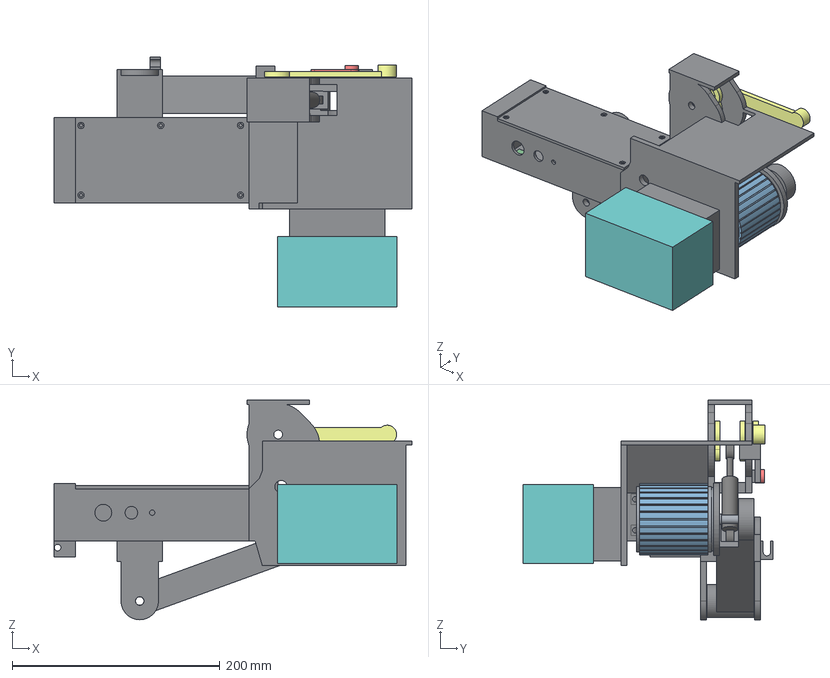
[picture p13: CAD file, 2026-11-08]
STEP/postroller_unit.step
344.5 x 240.8 x 211.2 mm
housing_front
housing_rear
bay_lid
swing_arm
lift_crank_inner
lift_crank_outer
lift_handle
roller_sleeve
motor_6374
gas_spring
bearing_608 x 3
vesc_mks_mini67
esp32_c3_supermini
makita_dock_cc0
makita_battery_18v
estop_kicker
