ToleLin/E-bick/STL/base/D25p4/liner_D25p4_TPU95A.stl

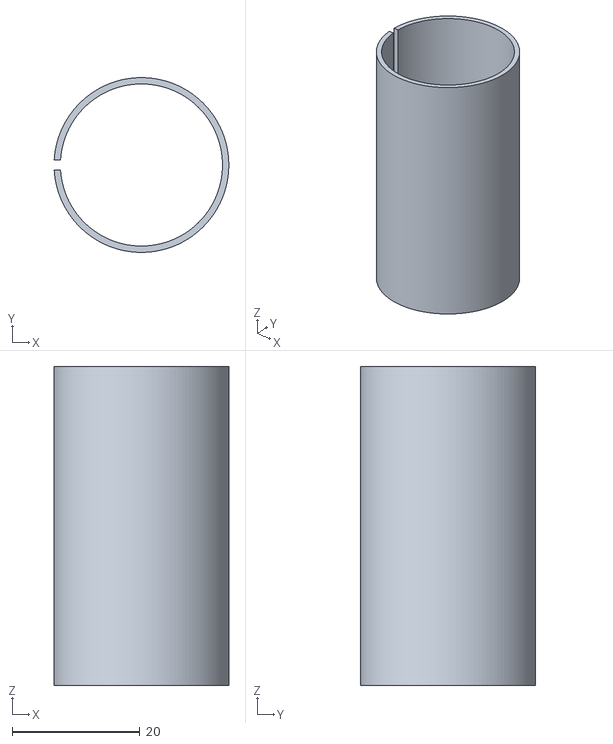
[picture p14: CAD file, 2026-11-08]
STL/base/D25p4/liner_D25p4_TPU95A.stl
27.4 x 27.4 x 50.0
