ToleLin/E-bick/STL/base/D27p2/liner_D27p2_TPU95A.stl

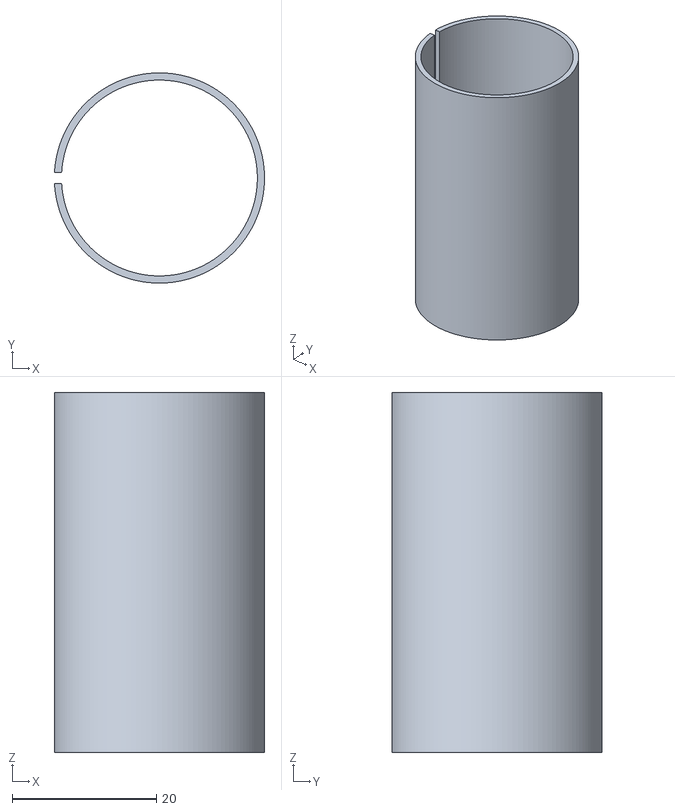
[picture p15: CAD file, 2026-11-08]
STL/base/D27p2/liner_D27p2_TPU95A.stl
29.2 x 29.2 x 50.0
