ToleLin/E-bick/STL/base/D28p6/base_front_D28p6_PETG-CF.stl

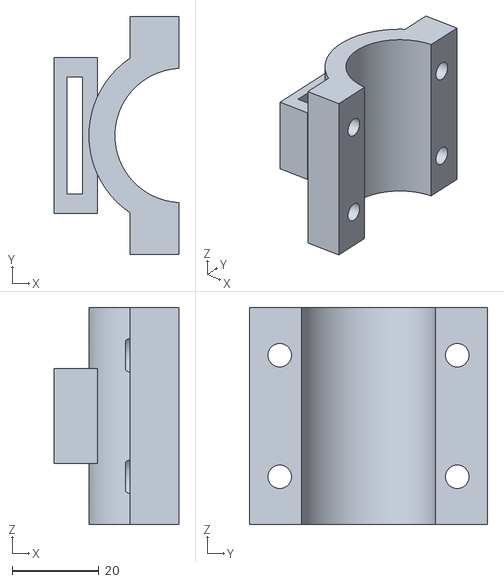
[picture p16: CAD file, 2026-11-08]
STL/base/D28p6/base_front_D28p6_PETG-CF.stl
28.7 x 54.9 x 50.0
