ToleLin/E-bick/STL/base/D30p9/liner_D30p9_TPU95A.stl

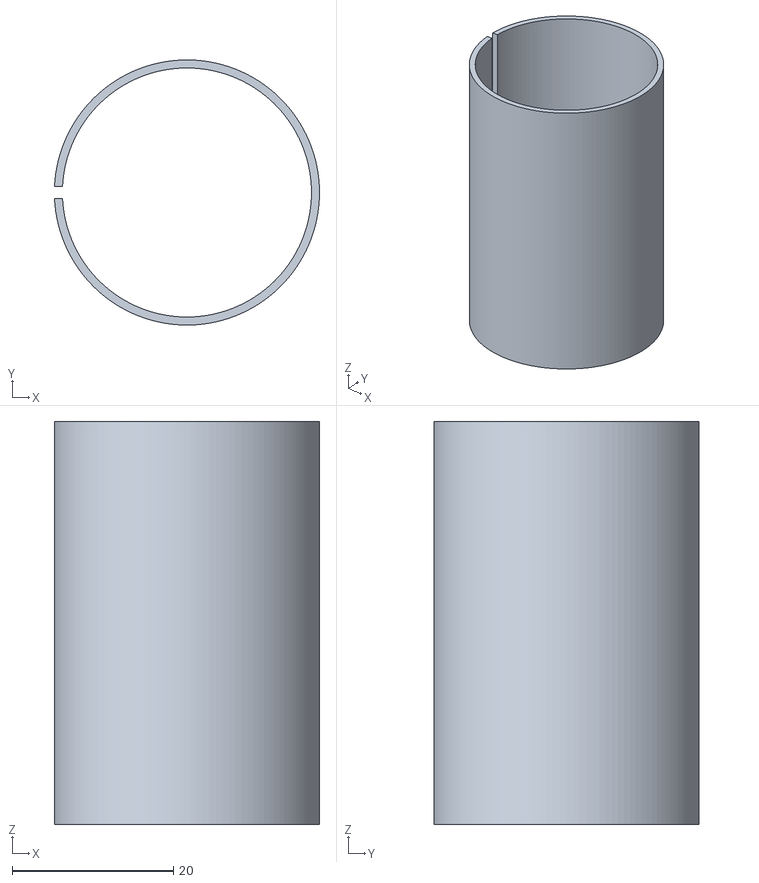
[picture p17: CAD file, 2026-11-08]
STL/base/D30p9/liner_D30p9_TPU95A.stl
32.9 x 32.9 x 50.0
