ToleLin/E-bick/STL/base/D31p6/base_rear_D31p6_fold_PETG-CF.stl

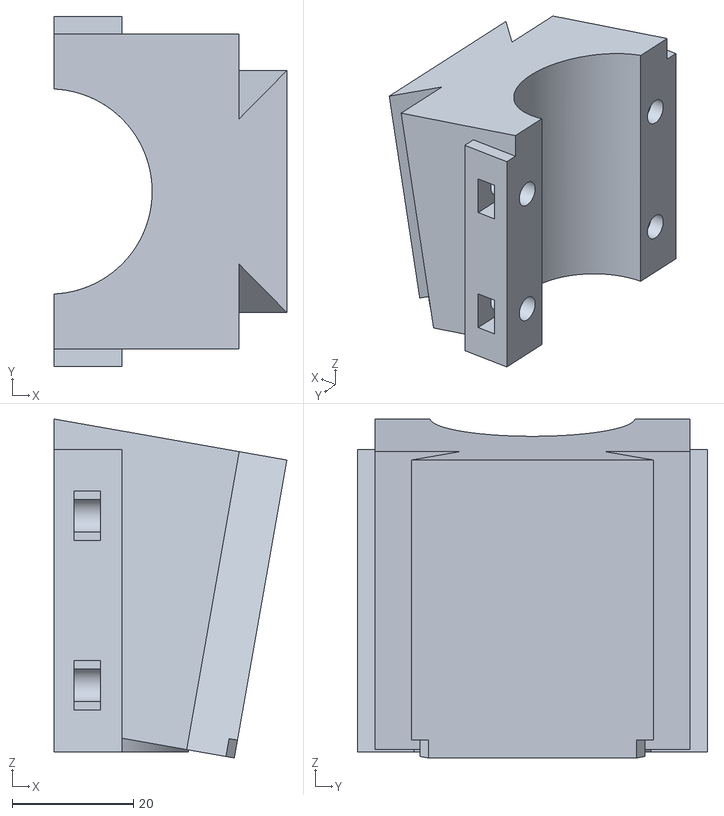
[picture p18: CAD file, 2026-11-08]
STL/base/D31p6/base_rear_D31p6_fold_PETG-CF.stl
38.5 x 57.9 x 56.0
