ToleLin/E-bick/STL/base/D33p9/base_rear_D33p9_minivelo_PETG-CF.stl

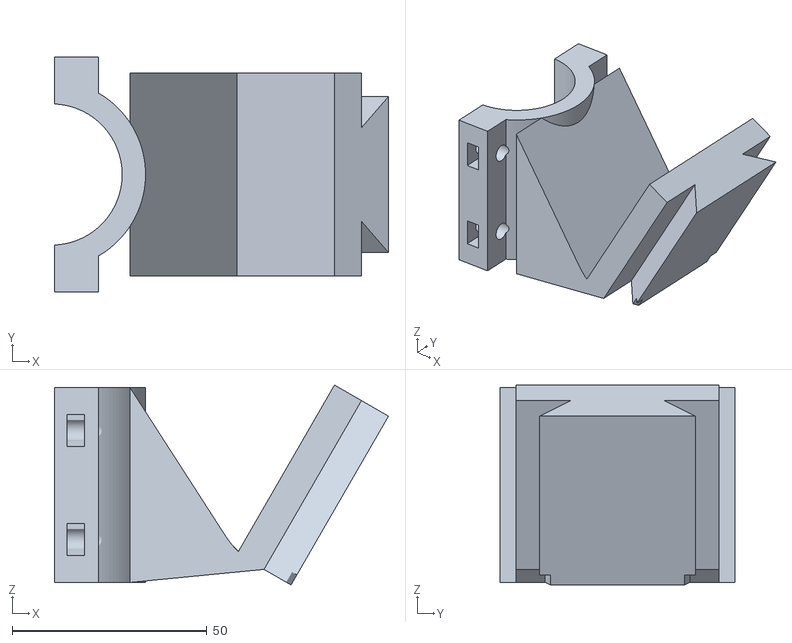
[picture p19: CAD file, 2026-11-08]
STL/base/D33p9/base_rear_D33p9_minivelo_PETG-CF.stl
85.7 x 60.2 x 51.3
