ToleLin/E-bick/STL/base/D34p9/base_rear_D34p9_mtb_PETG-CF.stl

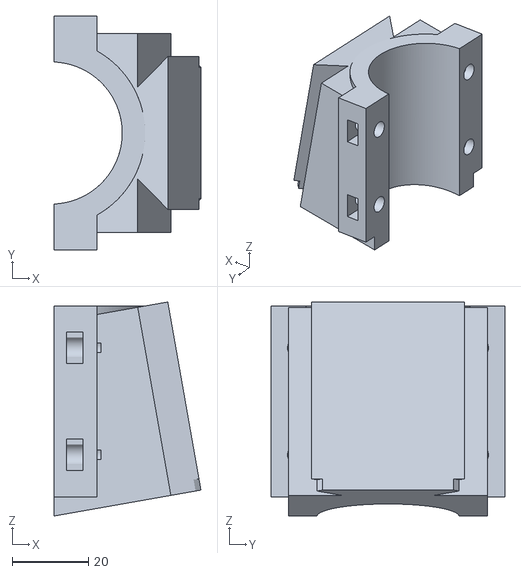
[picture p20: CAD file, 2026-11-08]
STL/base/D34p9/base_rear_D34p9_mtb_PETG-CF.stl
38.5 x 61.2 x 56.0
