ToleLin/E-bick/STL/estop_lever/L/estop_lever_blade_L_PETG-HF.stl

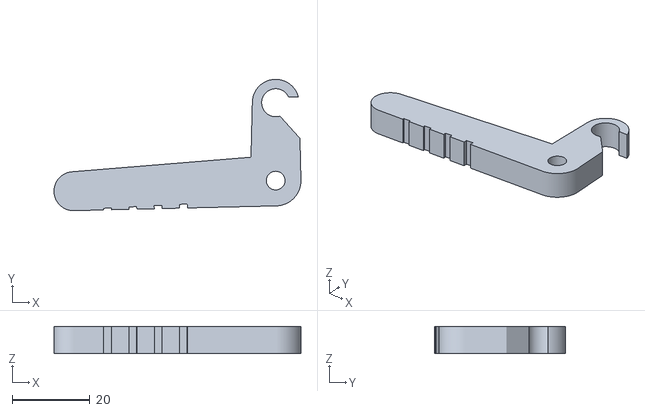
[picture p21: CAD file, 2026-11-08]
STL/estop_lever/L/estop_lever_blade_L_PETG-HF.stl
63.4 x 33.7 x 7.00
