ToleLin/E-bick/STL/estop_lever/R/estop_lever_lower_R_PETG-CF.stl

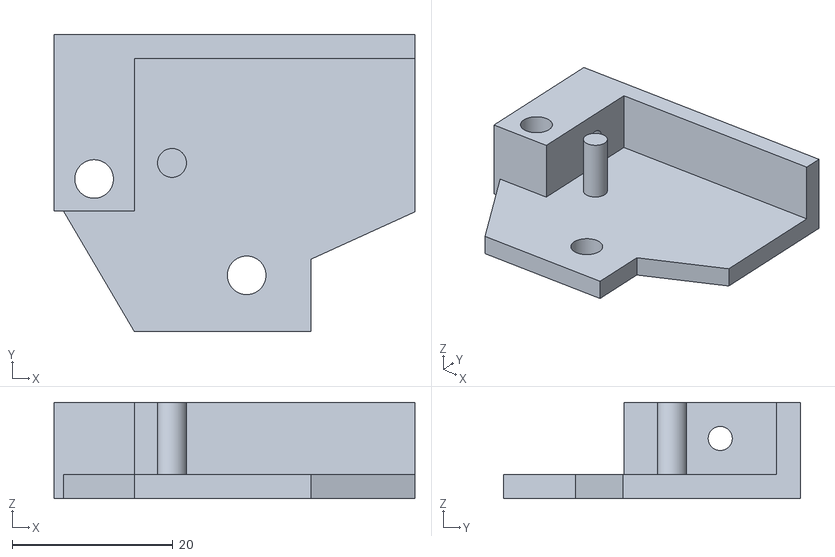
[picture p22: CAD file, 2026-11-08]
STL/estop_lever/R/estop_lever_lower_R_PETG-CF.stl
45.0 x 37.0 x 12.0
