ToleLin/E-bick/STL/unit/01_housing_front_PETG-CF.stl

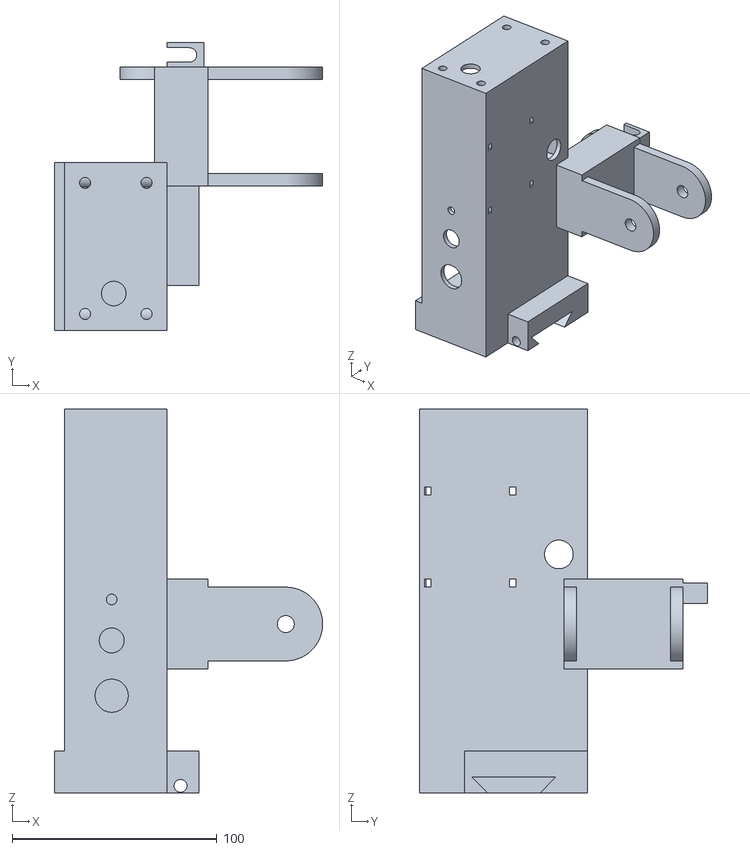
[picture p23: CAD file, 2026-11-08]
STL/unit/01_housing_front_PETG-CF.stl
131.0 x 140.5 x 187.5
