ToleLin/E-bick/STL/base/D25p4/base_rear_D25p4_minivelo_PETG-CF.stl

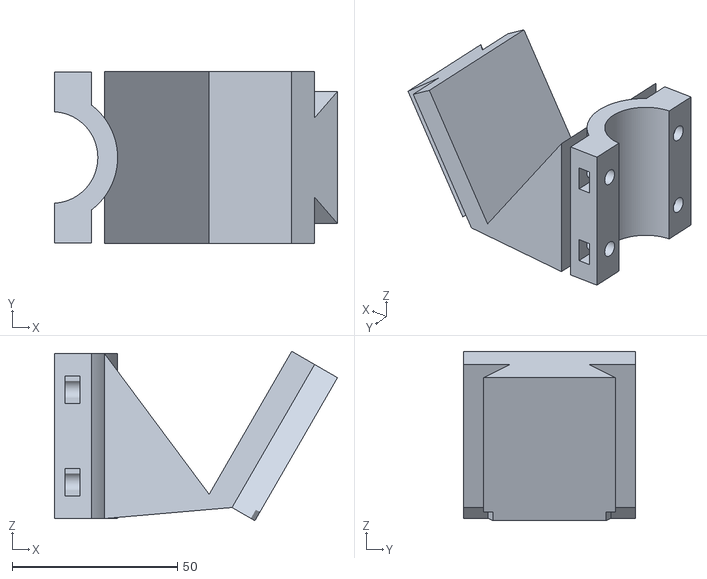
[picture p24: CAD file, 2026-11-08]
STL/base/D25p4/base_rear_D25p4_minivelo_PETG-CF.stl
85.7 x 52.0 x 51.3
