ToleLin/E-bick/STL/base/D27p2/base_rear_D27p2_fold_PETG-CF.stl

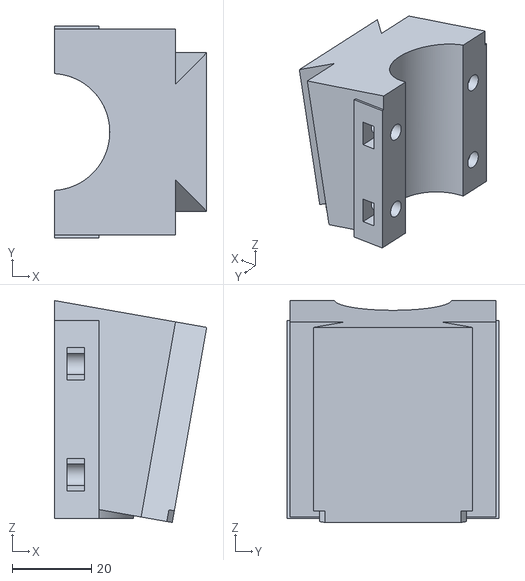
[picture p25: CAD file, 2026-11-08]
STL/base/D27p2/base_rear_D27p2_fold_PETG-CF.stl
38.5 x 53.5 x 56.0
