ToleLin/E-bick/STL/base/D28p6/base_rear_D28p6_mtb_PETG-CF.stl

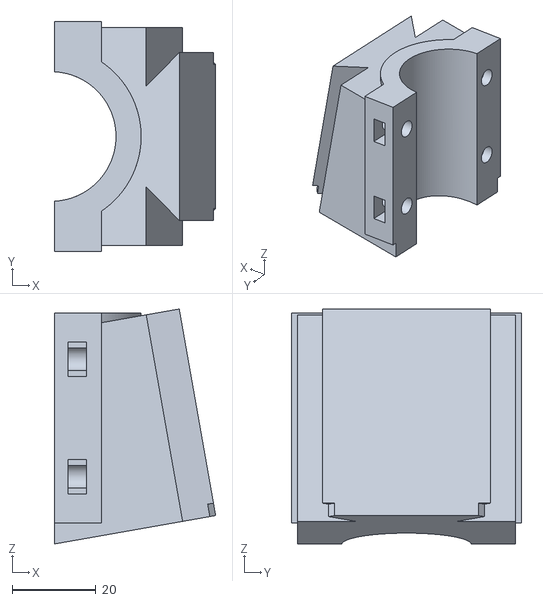
[picture p26: CAD file, 2026-11-08]
STL/base/D28p6/base_rear_D28p6_mtb_PETG-CF.stl
38.5 x 54.9 x 56.0
