ToleLin/E-bick/STL/base/D30p9/base_rear_D30p9_minivelo_PETG-CF.stl

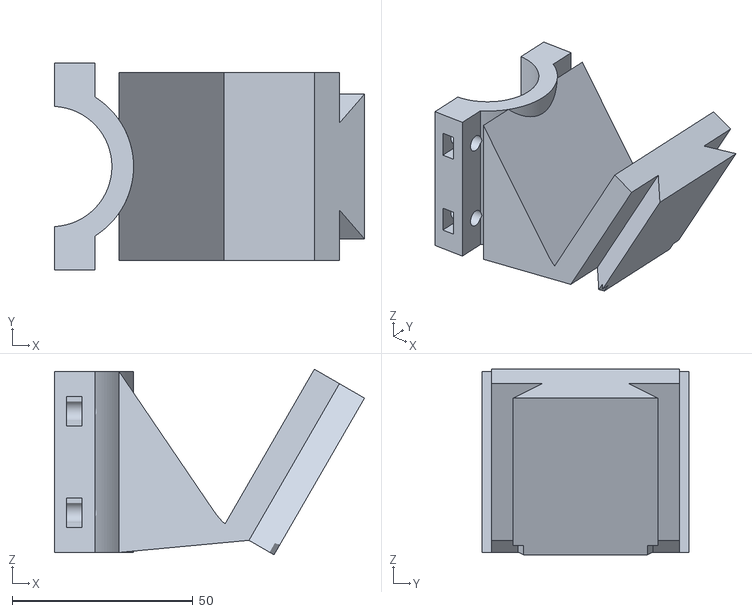
[picture p27: CAD file, 2026-11-08]
STL/base/D30p9/base_rear_D30p9_minivelo_PETG-CF.stl
85.7 x 57.2 x 51.3
