ToleLin/E-bick/STL/base/D33p9/liner_D33p9_TPU95A.stl

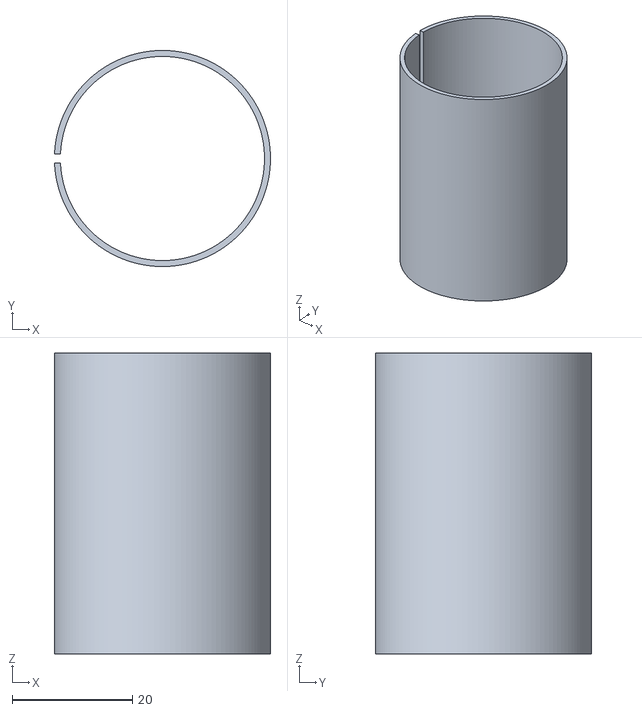
[picture p28: CAD file, 2026-11-08]
STL/base/D33p9/liner_D33p9_TPU95A.stl
35.9 x 35.9 x 50.0
