ToleLin/E-bick/STL/base/D34p9/base_rear_D34p9_std_PETG-CF.stl

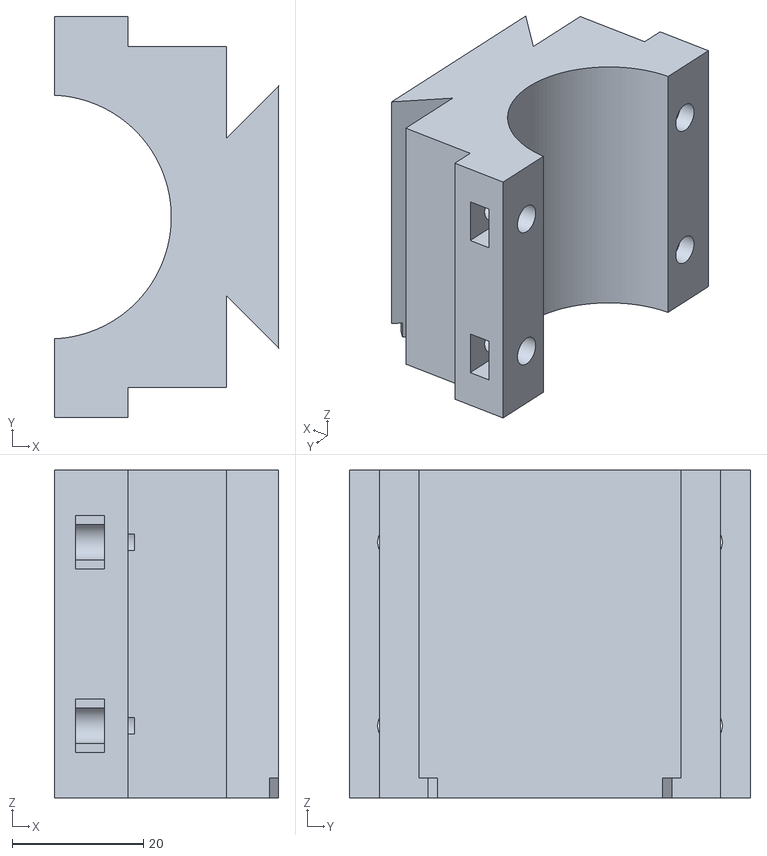
[picture p29: CAD file, 2026-11-08]
STL/base/D34p9/base_rear_D34p9_std_PETG-CF.stl
34.2 x 61.2 x 50.0
