ToleLin/E-bick/STL/estop_lever/L/estop_lever_upper_bar23p8_L_PETG-CF.stl

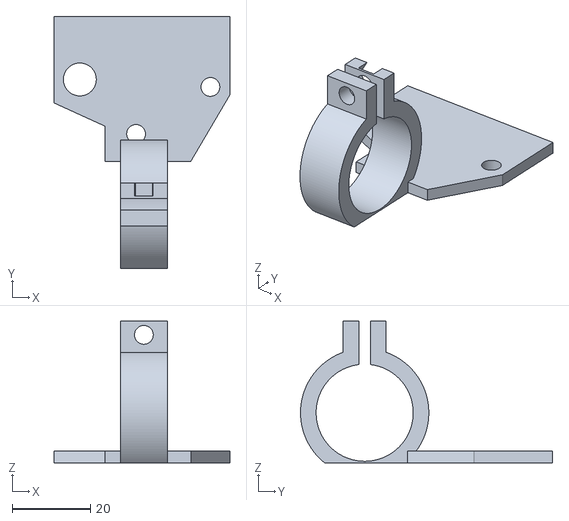
[picture p30: CAD file, 2026-11-08]
STL/estop_lever/L/estop_lever_upper_bar23p8_L_PETG-CF.stl
45.0 x 64.4 x 36.2
