ToleLin/E-bick/STL/estop_lever/R/estop_lever_upper_bar25p4_R_PETG-CF.stl

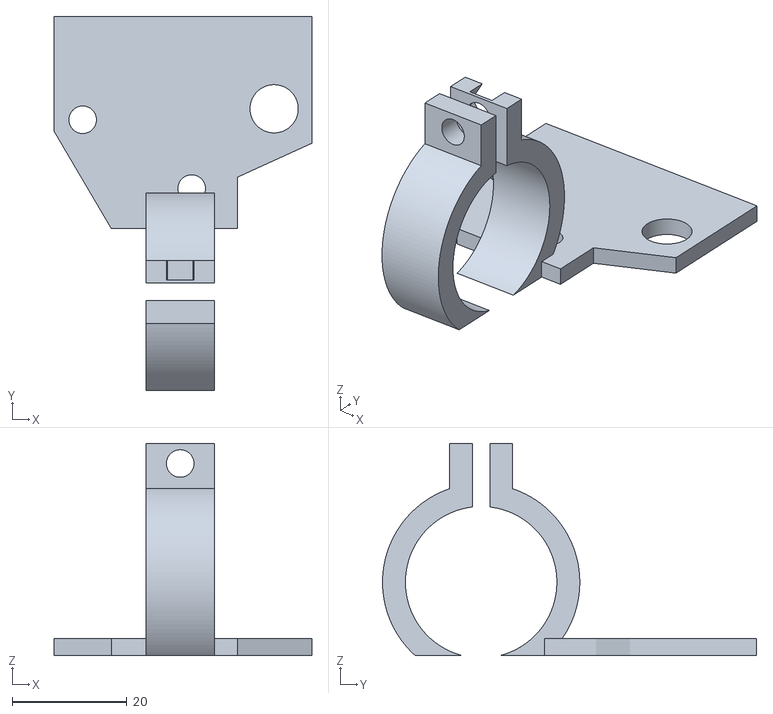
[picture p31: CAD file, 2026-11-08]
STL/estop_lever/R/estop_lever_upper_bar25p4_R_PETG-CF.stl
45.0 x 65.2 x 37.0
