ToleLin/E-bick/STL/unit/10_estop_kicker_PETG-HF.stl

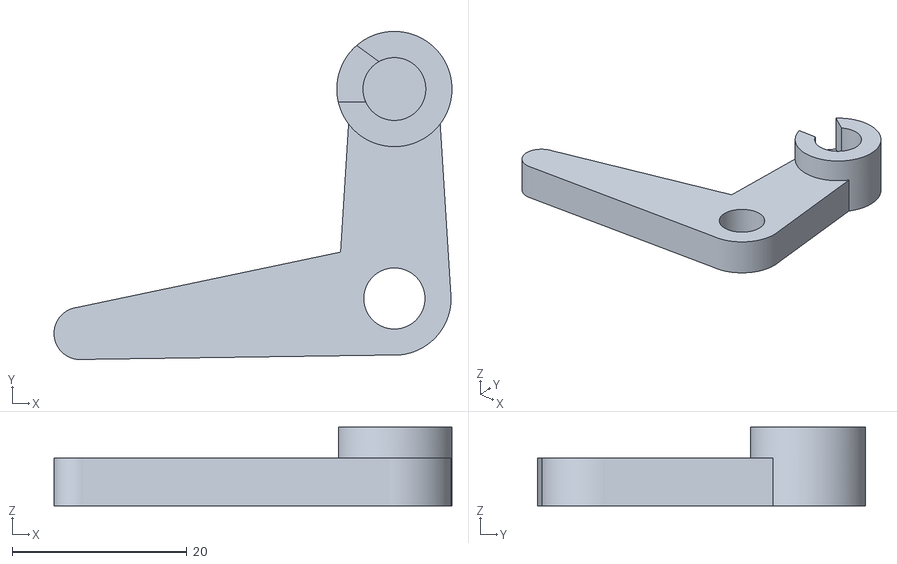
[picture p32: CAD file, 2026-11-08]
STL/unit/10_estop_kicker_PETG-HF.stl
45.6 x 37.6 x 9.00
