ToleLin/E-bick/STL/base/D25p4/base_rear_D25p4_std_PETG-CF.stl

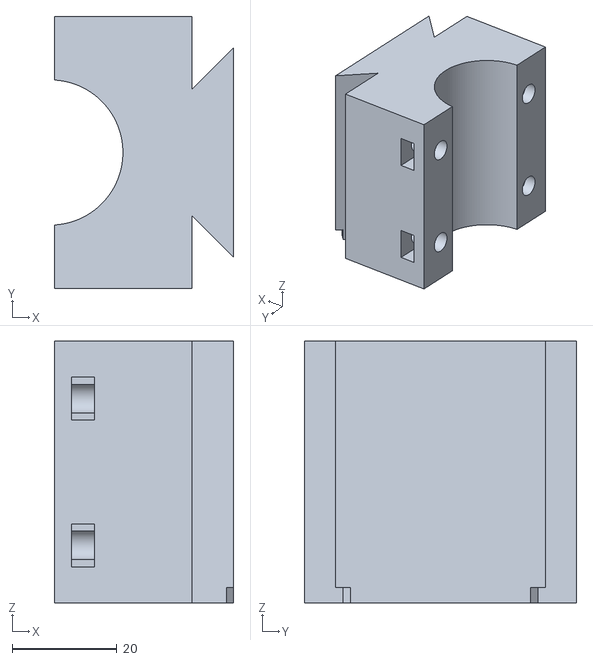
[picture p33: CAD file, 2026-11-08]
STL/base/D25p4/base_rear_D25p4_std_PETG-CF.stl
34.2 x 52.0 x 50.0
