ToleLin/E-bick/STL/base/D27p2/base_front_D27p2_PETG-CF.stl

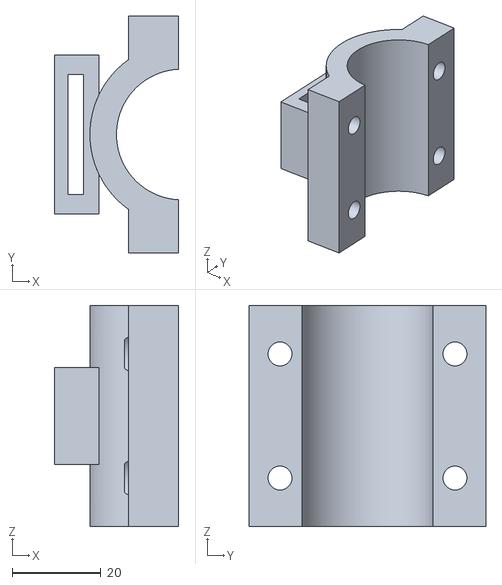
[picture p34: CAD file, 2026-11-08]
STL/base/D27p2/base_front_D27p2_PETG-CF.stl
28.0 x 53.5 x 50.0
