ToleLin/E-bick/STL/base/D28p6/liner_D28p6_TPU95A.stl

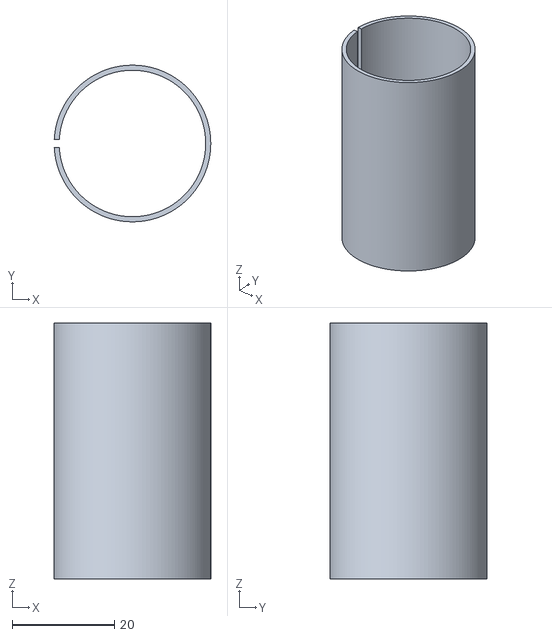
[picture p35: CAD file, 2026-11-08]
STL/base/D28p6/liner_D28p6_TPU95A.stl
30.6 x 30.6 x 50.0
