ToleLin/E-bick/STL/base/D30p9/base_rear_D30p9_fold_PETG-CF.stl

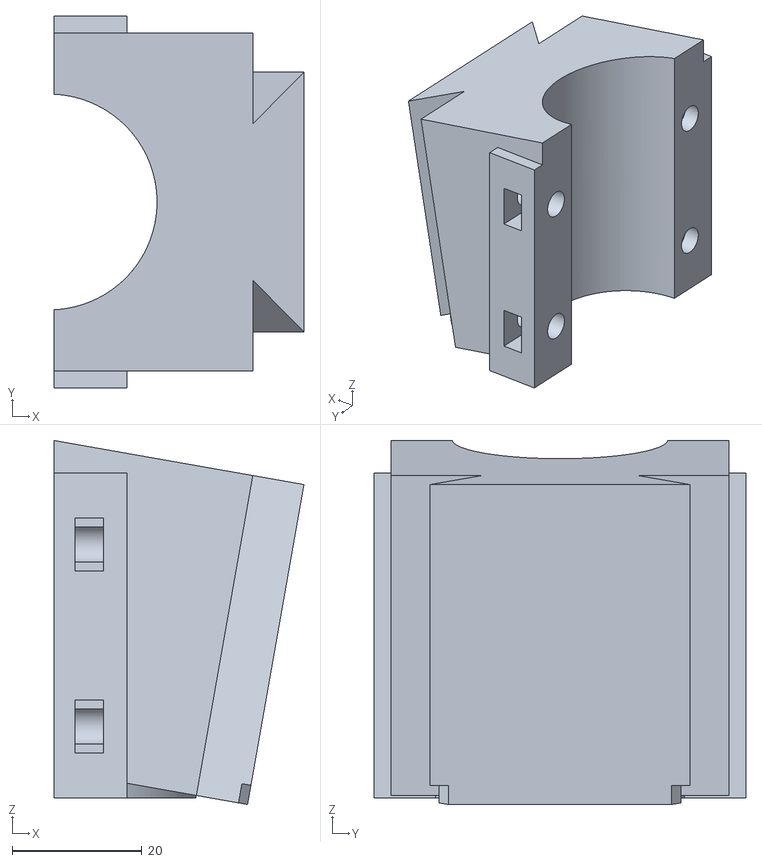
[picture p36: CAD file, 2026-11-08]
STL/base/D30p9/base_rear_D30p9_fold_PETG-CF.stl
38.5 x 57.2 x 56.0
