ToleLin/E-bick/STL/base/D31p6/base_rear_D31p6_std_PETG-CF.stl

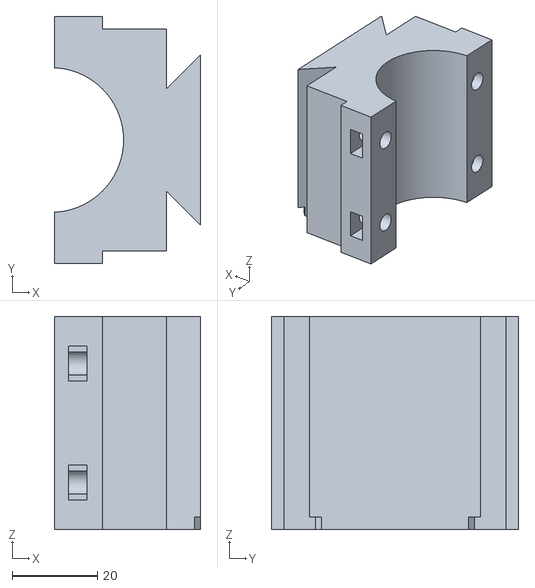
[picture p37: CAD file, 2026-11-08]
STL/base/D31p6/base_rear_D31p6_std_PETG-CF.stl
34.2 x 57.9 x 50.0
