ToleLin/E-bick/STL/base/D33p9/base_rear_D33p9_fold_PETG-CF.stl

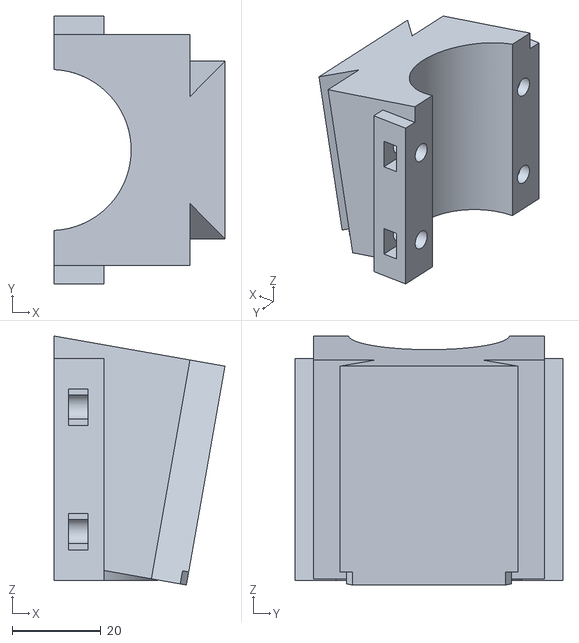
[picture p38: CAD file, 2026-11-08]
STL/base/D33p9/base_rear_D33p9_fold_PETG-CF.stl
38.5 x 60.2 x 56.0
