ToleLin/E-bick/STL/base/D34p9/base_front_D34p9_PETG-CF.stl

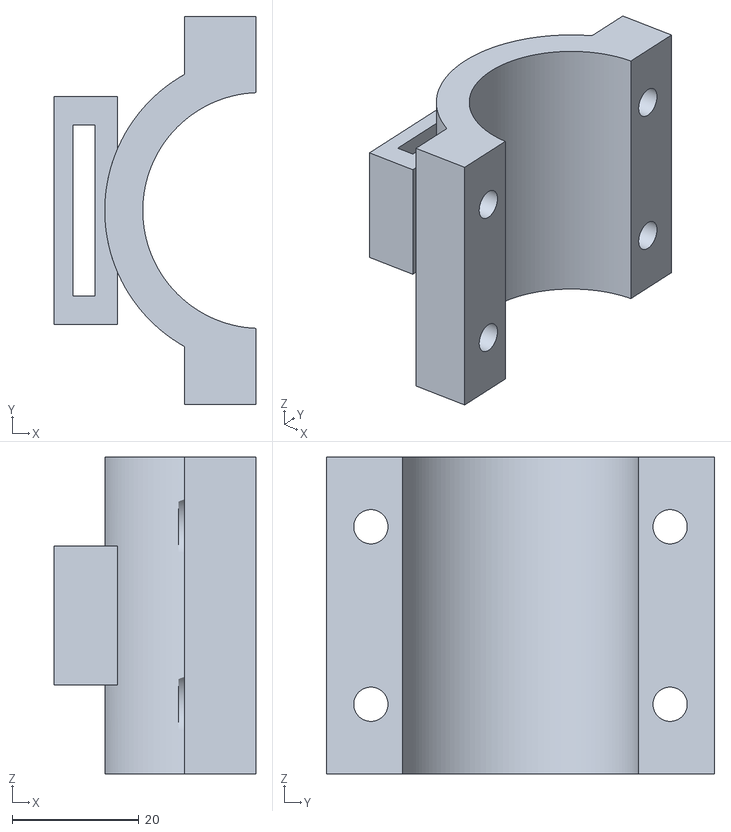
[picture p39: CAD file, 2026-11-08]
STL/base/D34p9/base_front_D34p9_PETG-CF.stl
31.9 x 61.2 x 50.0
