ToleLin/E-bick/STL/estop_lever/L/estop_lever_upper_bar22p2_L_PETG-CF.stl

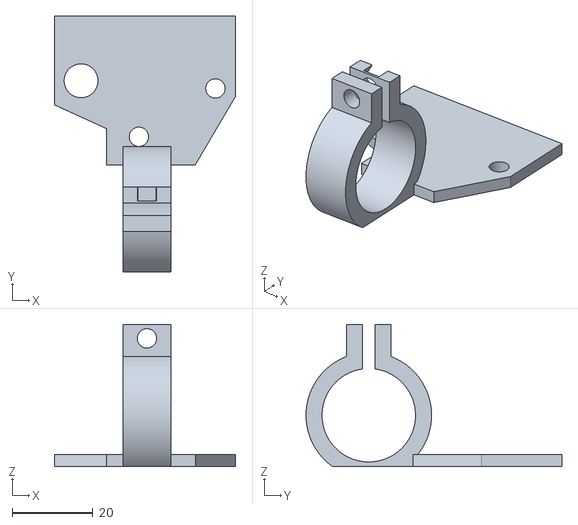
[picture p40: CAD file, 2026-11-08]
STL/estop_lever/L/estop_lever_upper_bar22p2_L_PETG-CF.stl
45.0 x 63.6 x 35.4
