ToleLin/E-bick/STL/unit/09_spacer_kicker_x1_PETG-HF.stl

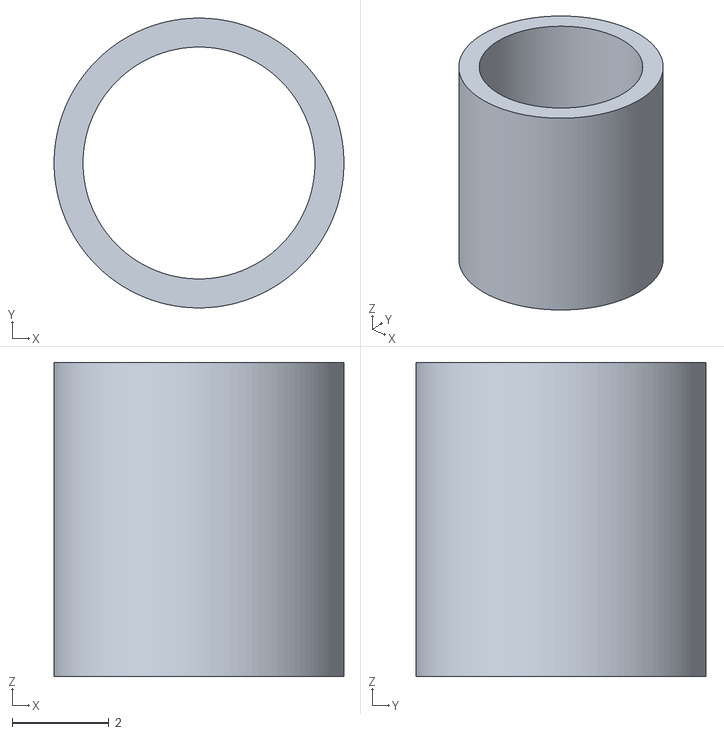
[picture p41: CAD file, 2026-11-08]
STL/unit/09_spacer_kicker_x1_PETG-HF.stl
6.00 x 6.00 x 6.50
