ToleLin/E-bick/STL/base/D25p4/base_rear_D25p4_mtb_PETG-CF.stl

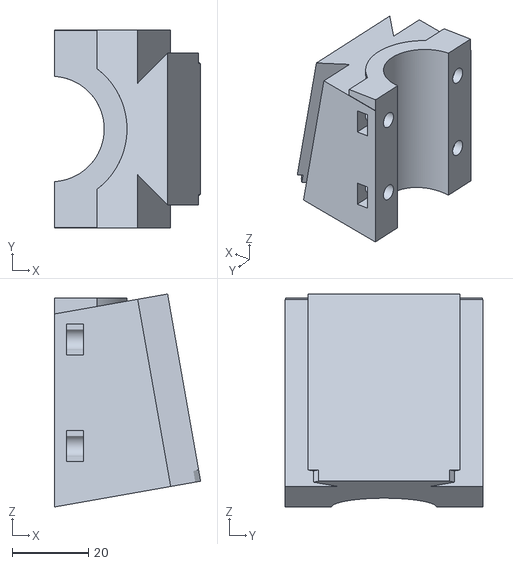
[picture p42: CAD file, 2026-11-08]
STL/base/D25p4/base_rear_D25p4_mtb_PETG-CF.stl
38.5 x 52.0 x 56.0
