ToleLin/E-bick/STL/base/D27p2/base_rear_D27p2_minivelo_PETG-CF.stl

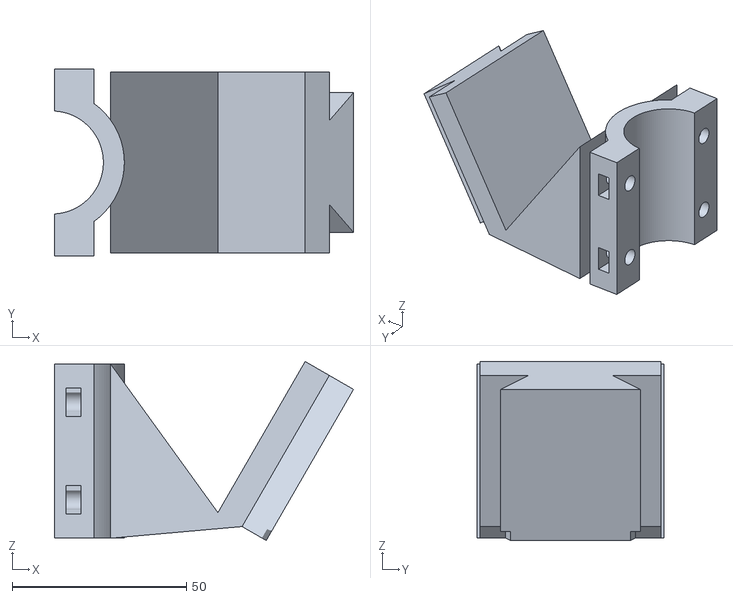
[picture p43: CAD file, 2026-11-08]
STL/base/D27p2/base_rear_D27p2_minivelo_PETG-CF.stl
85.7 x 53.5 x 51.3
