ToleLin/E-bick/STL/base/D28p6/base_rear_D28p6_minivelo_PETG-CF.stl

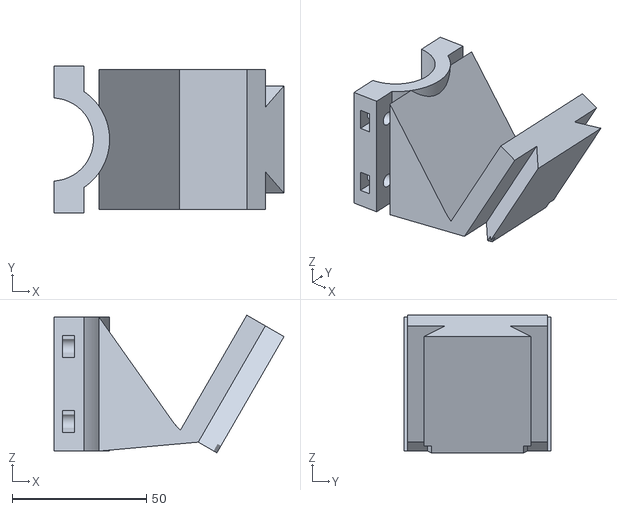
[picture p44: CAD file, 2026-11-08]
STL/base/D28p6/base_rear_D28p6_minivelo_PETG-CF.stl
85.7 x 54.9 x 51.3
