ToleLin/E-bick/STL/base/D30p9/base_rear_D30p9_std_PETG-CF.stl

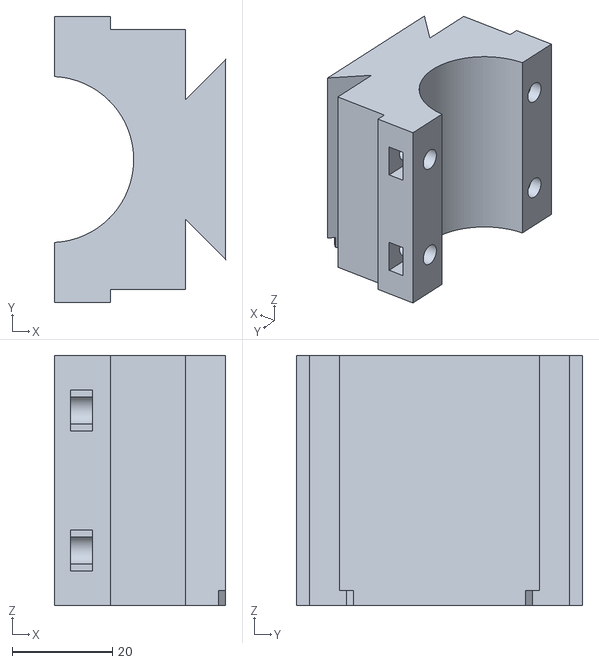
[picture p45: CAD file, 2026-11-08]
STL/base/D30p9/base_rear_D30p9_std_PETG-CF.stl
34.2 x 57.2 x 50.0
