ToleLin/E-bick/STL/base/D31p6/base_front_D31p6_PETG-CF.stl

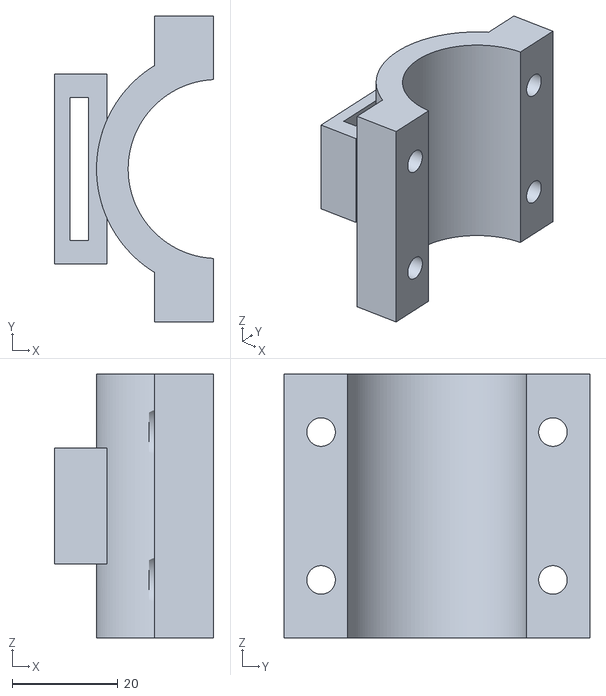
[picture p46: CAD file, 2026-11-08]
STL/base/D31p6/base_front_D31p6_PETG-CF.stl
30.2 x 57.9 x 50.0
