ToleLin/E-bick/STL/base/D34p9/liner_D34p9_TPU95A.stl

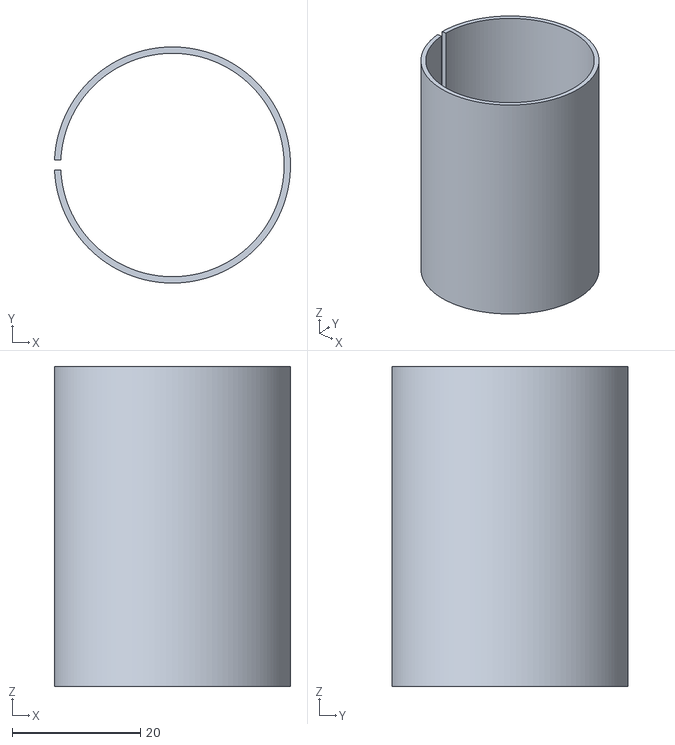
[picture p47: CAD file, 2026-11-08]
STL/base/D34p9/liner_D34p9_TPU95A.stl
36.9 x 36.9 x 50.0
