ToleLin/E-bick/STL/unit/02_housing_rear_PETG-CF.stl

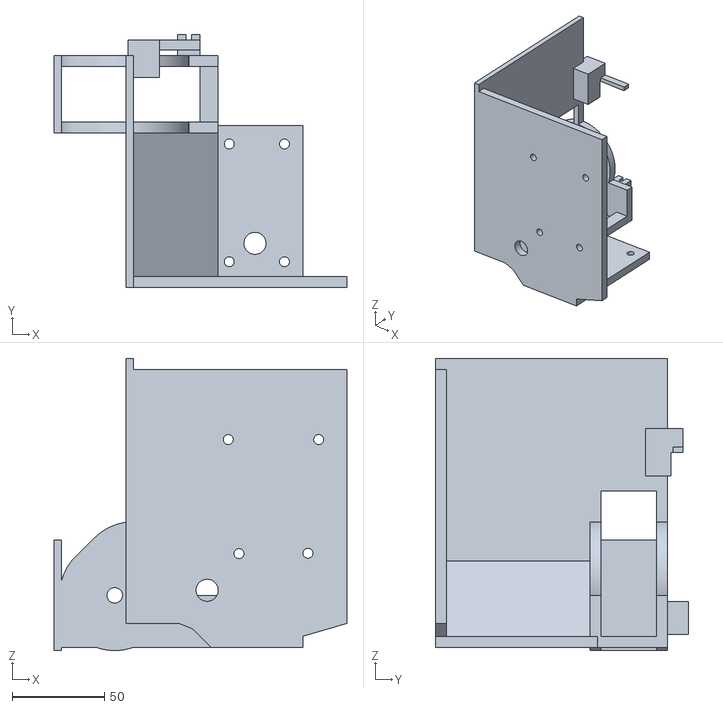
[picture p48: CAD file, 2026-11-08]
STL/unit/02_housing_rear_PETG-CF.stl
159.2 x 137.5 x 158.8
