ToleLin/E-bick/STL/base/D30p9/base_front_D30p9_PETG-CF.stl

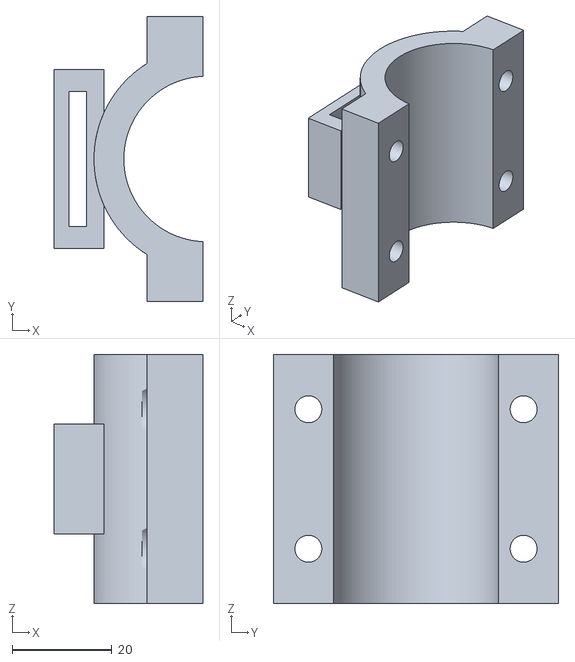
[picture p49: CAD file, 2026-11-08]
STL/base/D30p9/base_front_D30p9_PETG-CF.stl
29.9 x 57.2 x 50.0
