ToleLin/E-bick/STL/base/D31p6/liner_D31p6_TPU95A.stl

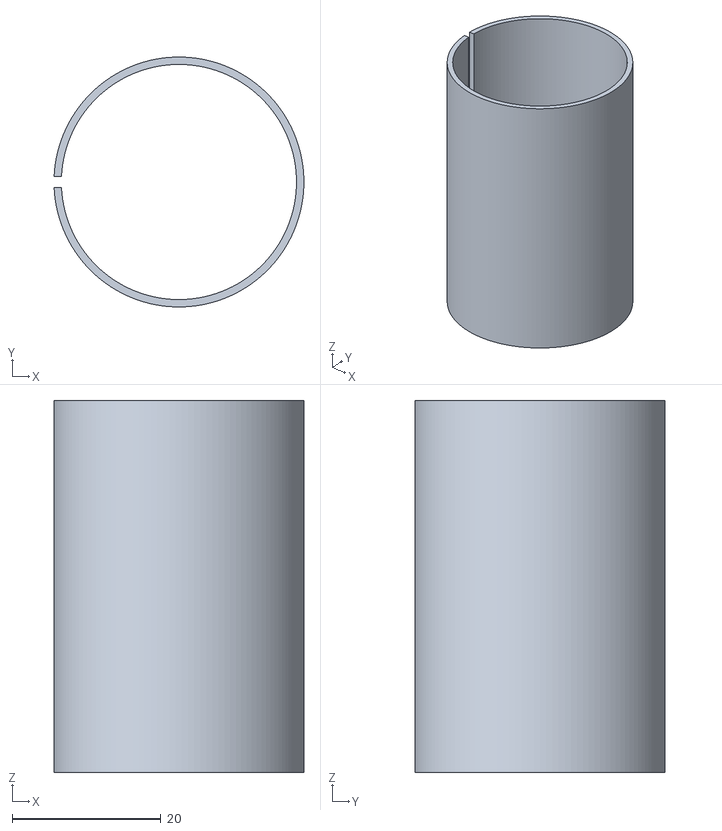
[picture p50: CAD file, 2026-11-08]
STL/base/D31p6/liner_D31p6_TPU95A.stl
33.6 x 33.6 x 50.0
