ToleLin/E-bick/STL/base/D33p9/base_rear_D33p9_std_PETG-CF.stl

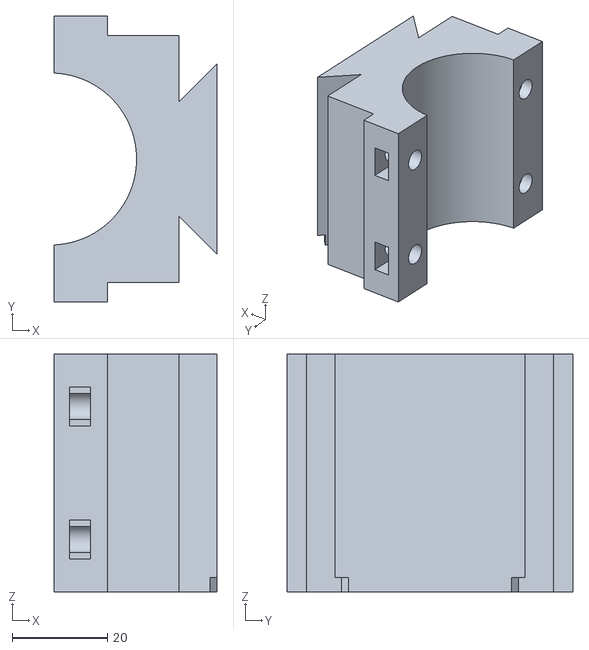
[picture p51: CAD file, 2026-11-08]
STL/base/D33p9/base_rear_D33p9_std_PETG-CF.stl
34.2 x 60.2 x 50.0
