ToleLin/E-bick/STL/unit/09_spacer_pivot_x1_PETG-HF.stl

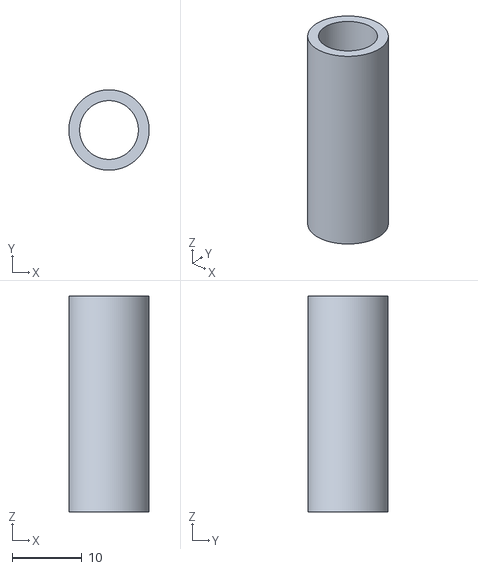
[picture p52: CAD file, 2026-11-08]
STL/unit/09_spacer_pivot_x1_PETG-HF.stl
11.5 x 11.5 x 30.9
