ToleLin/E-bick/STL/base/D25p4/base_front_D25p4_PETG-CF.stl

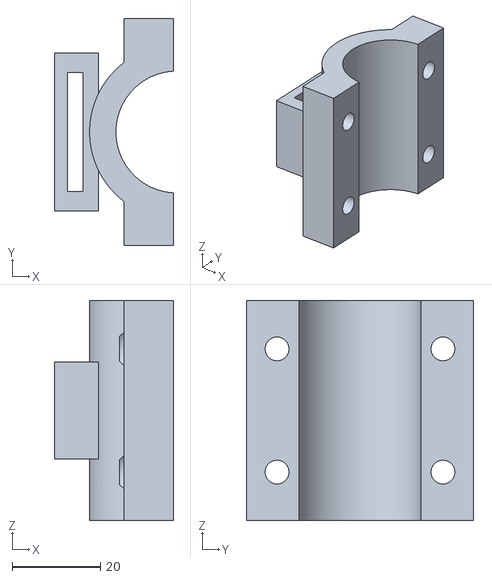
[picture p53: CAD file, 2026-11-08]
STL/base/D25p4/base_front_D25p4_PETG-CF.stl
27.1 x 51.7 x 50.0
