ToleLin/E-bick/STL/base/D27p2/base_rear_D27p2_std_PETG-CF.stl

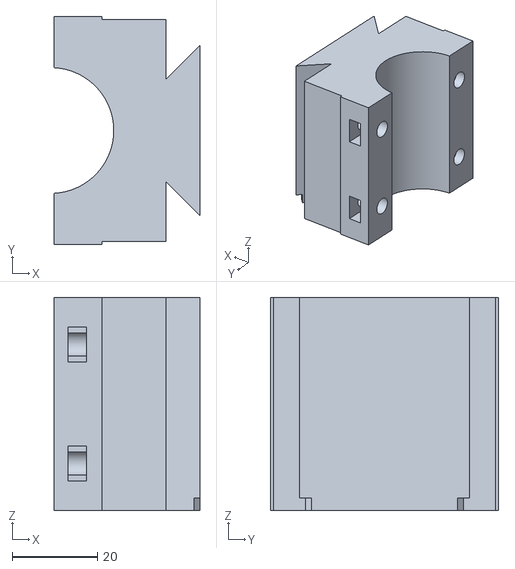
[picture p54: CAD file, 2026-11-08]
STL/base/D27p2/base_rear_D27p2_std_PETG-CF.stl
34.2 x 53.5 x 50.0
