ToleLin/E-bick/STL/base/D28p6/base_rear_D28p6_std_PETG-CF.stl

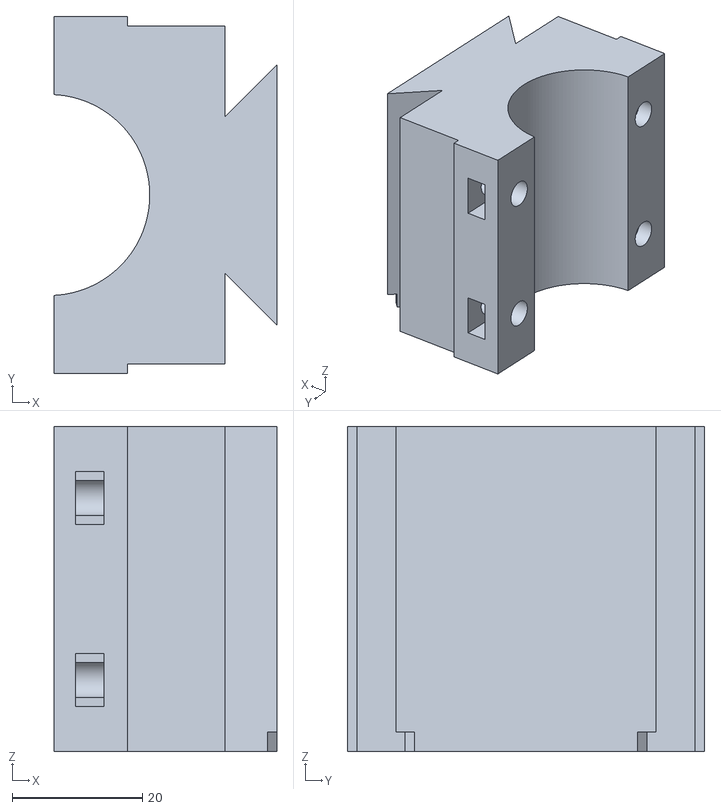
[picture p55: CAD file, 2026-11-08]
STL/base/D28p6/base_rear_D28p6_std_PETG-CF.stl
34.2 x 54.9 x 50.0
