ToleLin/E-bick/STL/base/D31p6/base_rear_D31p6_minivelo_PETG-CF.stl

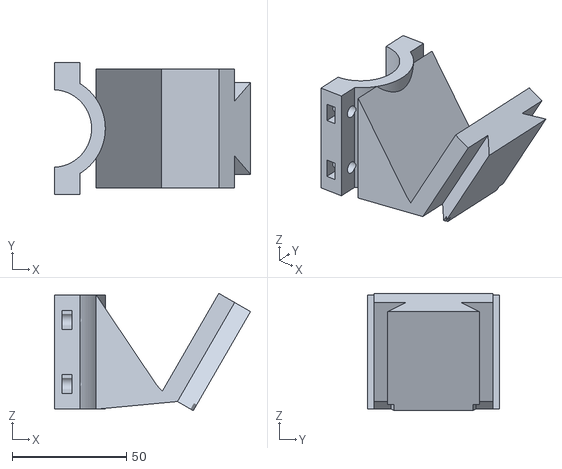
[picture p56: CAD file, 2026-11-08]
STL/base/D31p6/base_rear_D31p6_minivelo_PETG-CF.stl
85.7 x 57.9 x 51.3
