ToleLin/E-bick/STL/base/D33p9/base_front_D33p9_PETG-CF.stl

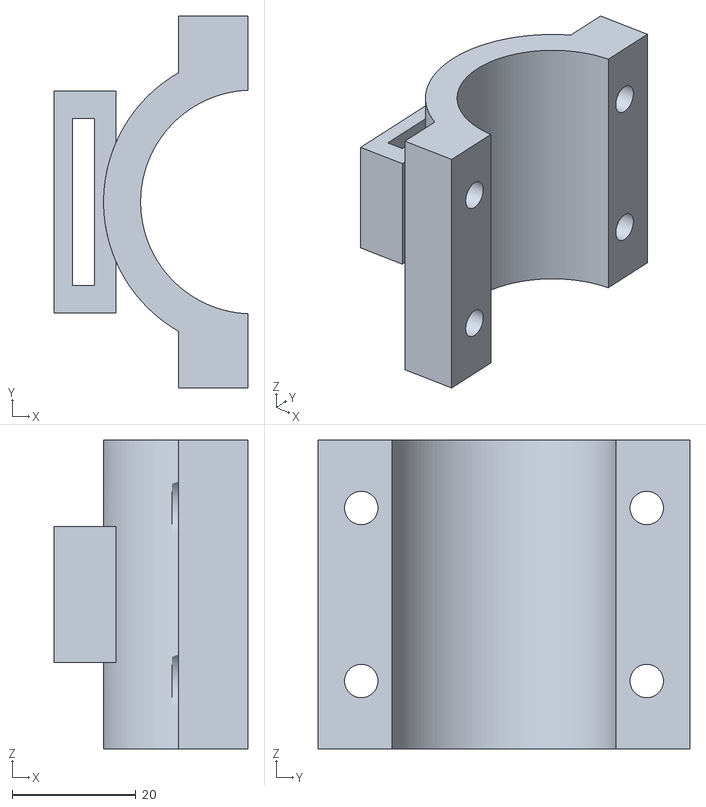
[picture p57: CAD file, 2026-11-08]
STL/base/D33p9/base_front_D33p9_PETG-CF.stl
31.4 x 60.2 x 50.0
