ToleLin/E-bick/STL/base/D34p9/base_rear_D34p9_minivelo_PETG-CF.stl

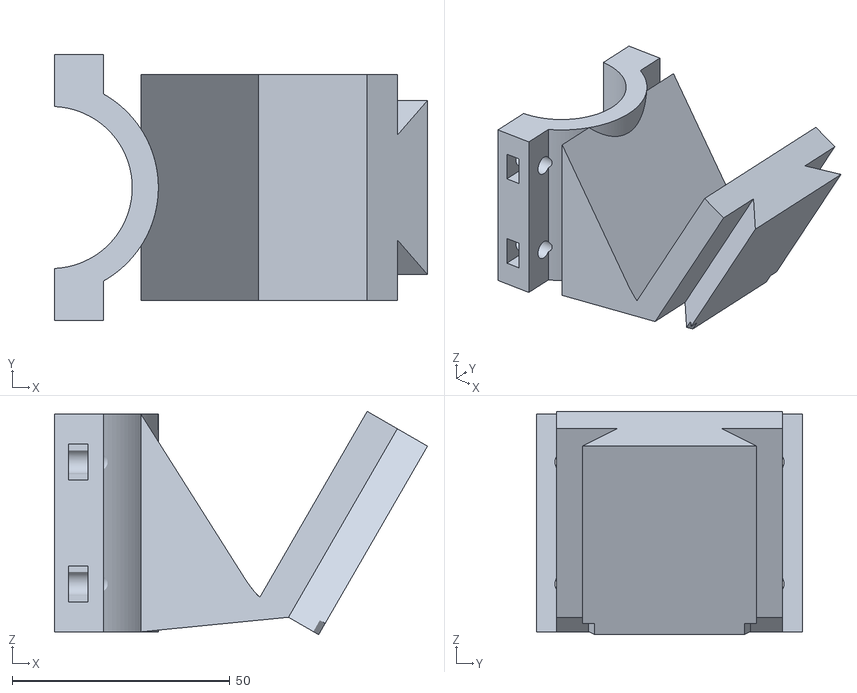
[picture p58: CAD file, 2026-11-08]
STL/base/D34p9/base_rear_D34p9_minivelo_PETG-CF.stl
85.7 x 61.2 x 51.3
