ToleLin/E-bick/STL/unit/09_spacer_eye_low_x2_PETG-HF.stl

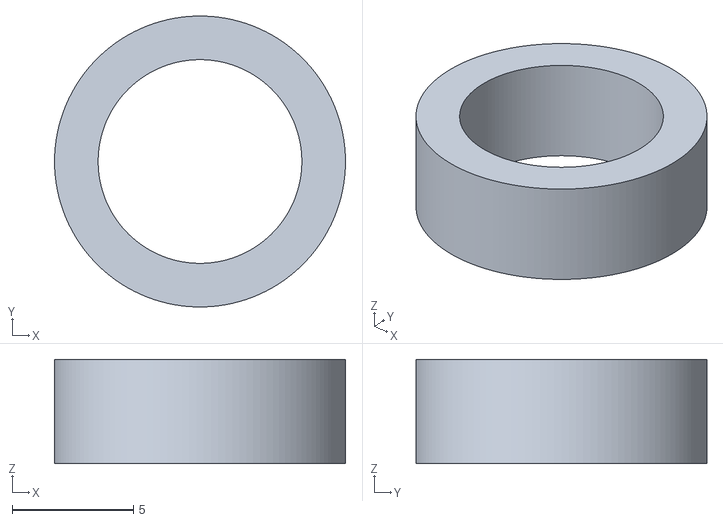
[picture p59: CAD file, 2026-11-08]
STL/unit/09_spacer_eye_low_x2_PETG-HF.stl
12.0 x 12.0 x 4.30
