ToleLin/E-bick/STL/unit/09_spacer_eye_top_x2_PETG-HF.stl

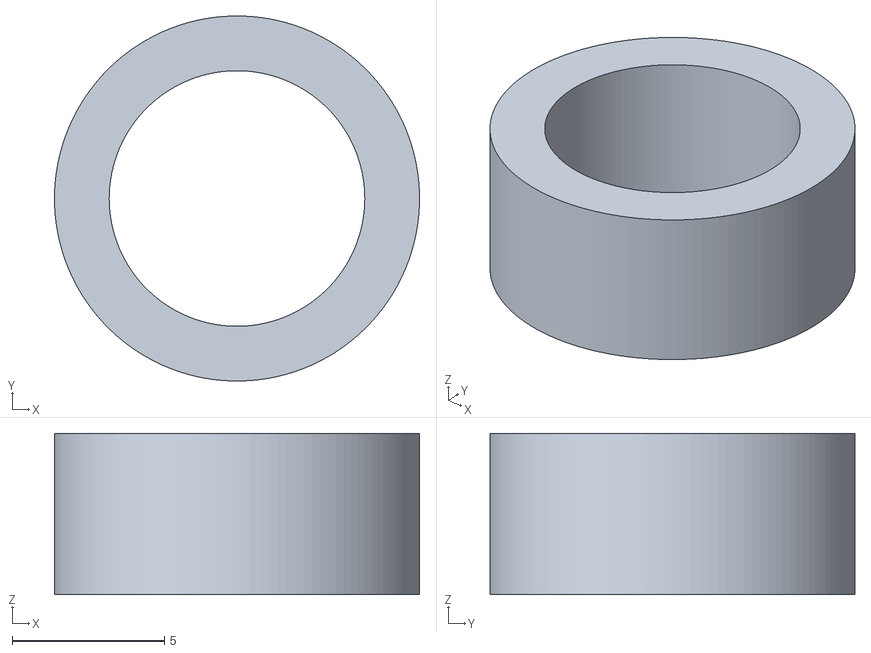
[picture p60: CAD file, 2026-11-08]
STL/unit/09_spacer_eye_top_x2_PETG-HF.stl
12.0 x 12.0 x 5.30
