ToleLin/E-bick/STL/unit/07_roller_sleeve_TPU95A.stl

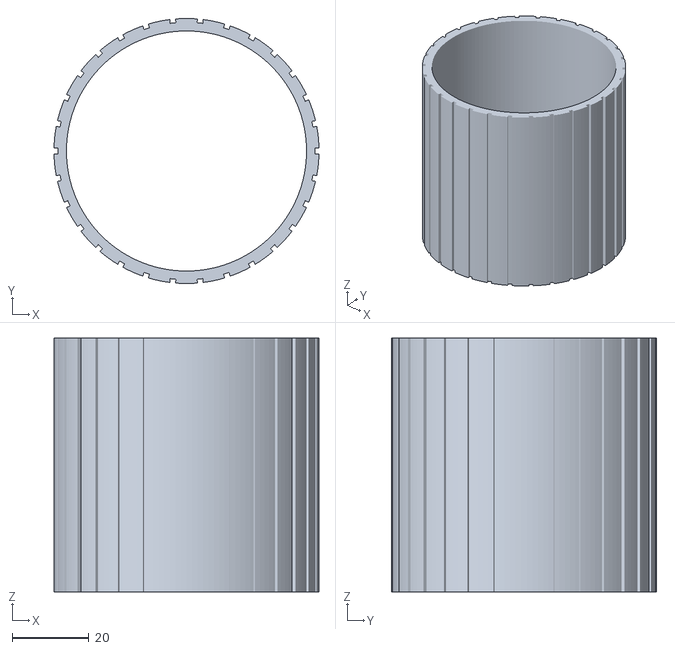
[picture p61: CAD file, 2026-11-08]
STL/unit/07_roller_sleeve_TPU95A.stl
69.0 x 69.0 x 66.0
