ToleLin/E-bick/STL/unit/06_lift_crank_outer_PETG-HF.stl

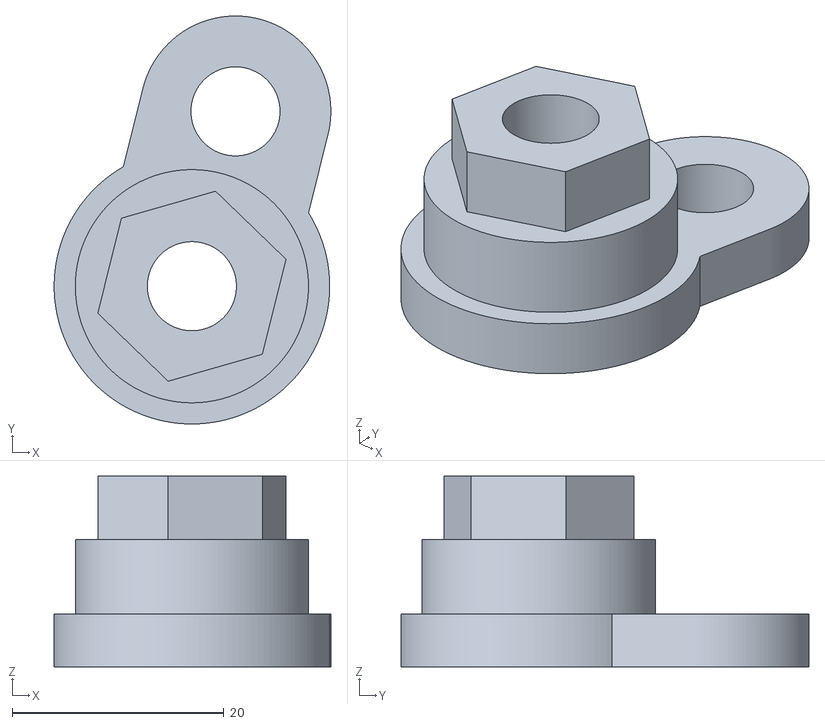
[picture p62: CAD file, 2026-11-08]
STL/unit/06_lift_crank_outer_PETG-HF.stl
26.1 x 38.5 x 18.0
