ToleLin/E-bick/STL/unit/04_swing_arm_PETG-CF.stl

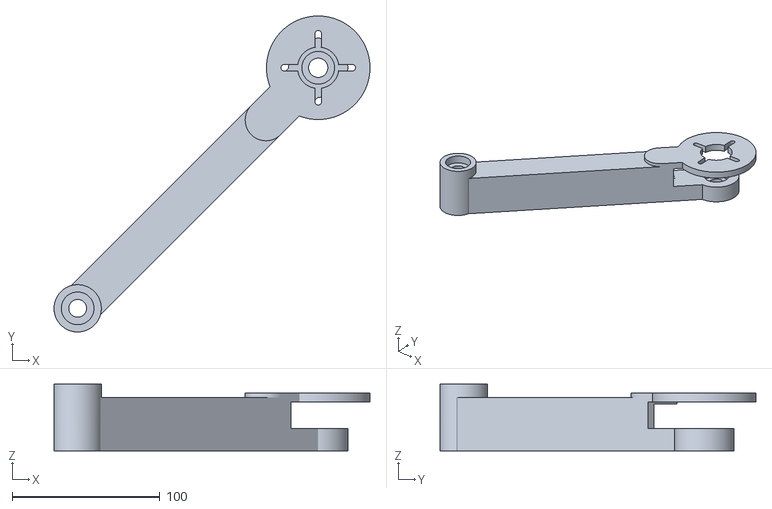
[picture p63: CAD file, 2026-11-08]
STL/unit/04_swing_arm_PETG-CF.stl
213.6 x 213.6 x 45.0
