ToleLin/E-bick/STL/unit/05_lift_crank_inner_PETG-HF.stl

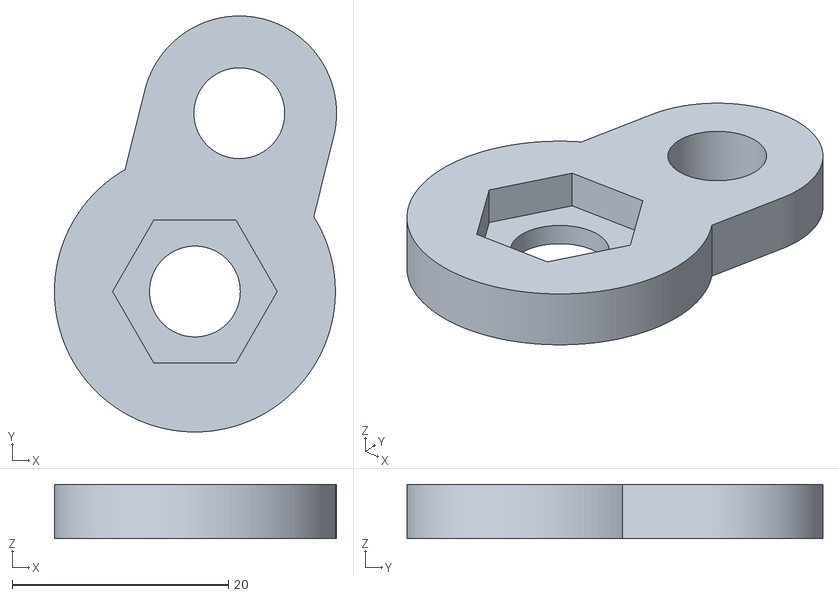
[picture p64: CAD file, 2026-11-08]
STL/unit/05_lift_crank_inner_PETG-HF.stl
26.1 x 38.5 x 5.00
