ToleLin/E-bick/STL/unit/03_bay_lid_PETG-CF.stl

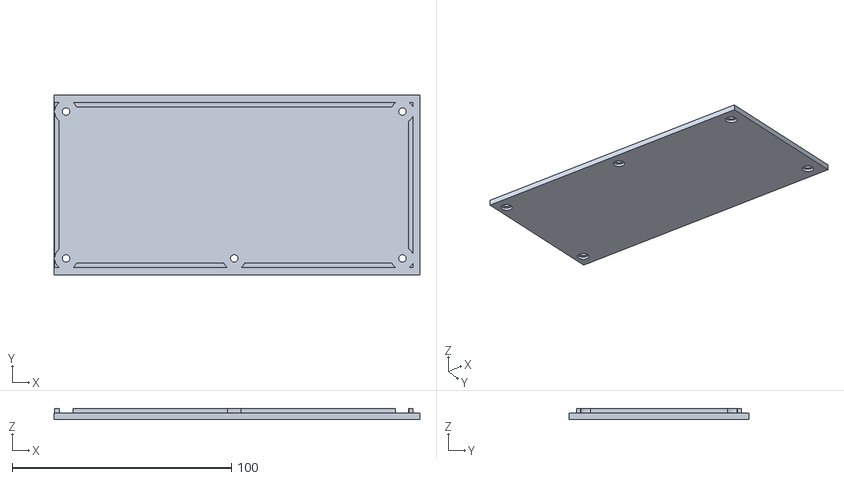
[picture p65: CAD file, 2026-11-08]
STL/unit/03_bay_lid_PETG-CF.stl
167.0 x 82.0 x 5.00
