ToleLin/E-bick/STL/unit/08_lift_handle_PETG-HF.stl

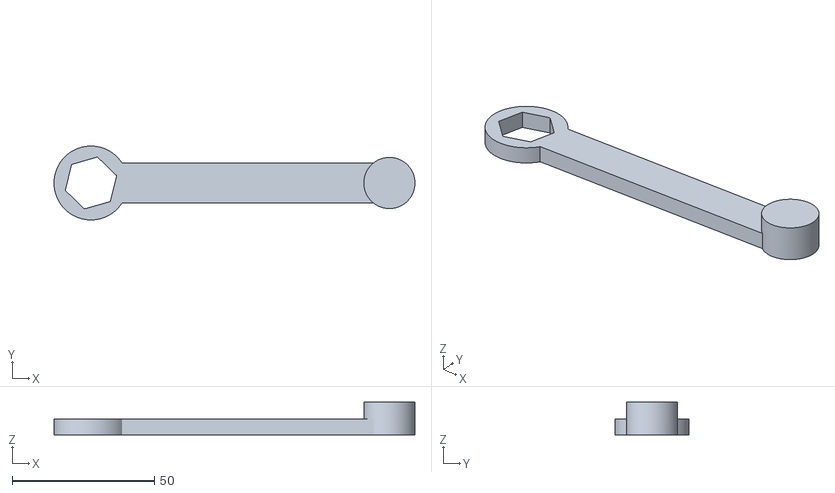
[picture p66: CAD file, 2026-11-08]
STL/unit/08_lift_handle_PETG-HF.stl
127.0 x 26.0 x 11.5
