ToleLin/E-bick/(list of files, cad)

Other CAD files:
STL/base/D31p6/base_rear_D31p6_mtb_PETG-CF.stl
STL/estop_lever/R/estop_lever_upper_bar23p8_R_PETG-CF.stl
STL/base/D33p9/base_rear_D33p9_mtb_PETG-CF.stl
STL/estop_lever/L/estop_lever_upper_bar25p4_L_PETG-CF.stl
STL/estop_lever/R/estop_lever_upper_bar22p2_R_PETG-CF.stl
STL/base/D25p4/base_rear_D25p4_fold_PETG-CF.stl
STL/base/D27p2/base_rear_D27p2_mtb_PETG-CF.stl
STL/base/D28p6/base_rear_D28p6_fold_PETG-CF.stl
STL/base/D34p9/base_rear_D34p9_fold_PETG-CF.stl
STL/estop_lever/L/estop_lever_lower_L_PETG-CF.stl
STL/estop_lever/R/estop_lever_blade_R_PETG-HF.stl
STL/base/D30p9/base_rear_D30p9_mtb_PETG-CF.stl
