ToleLin/E-bick/(commit log)

2026-11-08 PostRoller v0.1：開源快拆摩擦助力器
    座管座留在每台車上、主機燕尾快拆換車的 3D 列印摩擦驅動助力器。
    - build123d 參數化模型：座管座（7 種管徑 × 4 款傾角）、主機殼、擺臂、過死點抬臂機構
    - 8 種車型（公路、礫石、城市、29/27.5/26 吋登山、20 吋小徑與折疊）裝車與干涉驗證
    - 受力計算：250 N 氣壓棒，正向力 216–237 N
    - 列印擺放好的 STL、組件 STEP、ESP32-C3 踏頻助力韌體（VESC UART）
    - 文件：零件與採購、列印、組裝與接線、設計說明、台灣法規調查
    狀態：CAD 與計算驗證完成，尚未實際列印與騎乘測試。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
    [01_housing_front_PETG-CF.stl, 02_housing_rear_PETG-CF.stl, 03_bay_lid_PETG-CF.stl, 04_swing_arm_PETG-CF.stl, 05_lift_crank_inner_PETG-HF.stl, 06_lift_crank_outer_PETG-HF.stl, 07_roller_sleeve_TPU95A.stl, 08_lift_handle_PETG-HF.stl]
2026-11-08 v0.2：機械式緊急停止拉桿
    車把上的紅色拉桿經煞車線拉動主機上的觸發桿，從下面把過死點抬臂機構
    頂過死點 16°，氣壓棒自己把滾輪抬離輪胎；停住後自鎖，要回主機旁把
    把手壓回去才恢復。純機械，不靠電。
    - 主機：觸發桿＋墊管、後段殼的觸發桿支架與休止擋、塔外牆卡入式線管座、
    前段外耳板線管扣
    - 車把拉桿：上下兩件免支撐列印、管徑 22.2/23.8/25.4、左右鏡像
    - 檢查：check_estop（觸發角、拉線行程、全行程干涉）、estop_calc
    （8 車型過死點力矩與自鎖）；check_unit、check_bikes 仍全通過
    - 修正 xz_prism／xy_prism：順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
    [01_housing_front_PETG-CF.stl, 02_housing_rear_PETG-CF.stl, 09_spacer_kicker_x1_PETG-HF.stl, 10_estop_kicker_PETG-HF.stl, estop_lever_blade_L_PETG-HF.stl, estop_lever_blade_R_PETG-HF.stl, estop_lever_lower_L_PETG-CF.stl, estop_lever_lower_R_PETG-CF.stl]
2026-11-08 v0.3：緊急停止拉桿精簡＋0.2 cm 列印公差
    - 車把拉桿：樞軸移到車把正前方、線頭臂 20 mm、拉桿片 52 mm；座子 45×64×47 mm（原 56×74×50），三件 25 g（原 41 g）
    - 緊急停止相關列印件每邊留 1 mm（FIT）：M4 孔 Ø4.8、夾環孔 +1 mm 配 3 mm 鎖緊縫、線頭座 Ø7.2、線管頭座 Ø7.0
    - 主機端：觸發桿與支架間隙 1 mm、軸孔套 Ø6 墊管、線管座改側槽＋前方推入（不靠卡扣）、線管扣改 7 mm U 型槽
    - check_estop／check_unit／check_bikes 全部通過；STL、STEP、文件同步更新
    [01_housing_front_PETG-CF.stl, 02_housing_rear_PETG-CF.stl, 09_spacer_kicker_x1_PETG-HF.stl, 10_estop_kicker_PETG-HF.stl, estop_lever_blade_L_PETG-HF.stl, estop_lever_blade_R_PETG-HF.stl, estop_lever_lower_L_PETG-CF.stl, estop_lever_lower_R_PETG-CF.stl]
2026-11-09 docs：05 拉桿圖改成靜止／拉到底並排
    原本說明寫「左：靜止，右：拉到底」，但只放了一張圖。
